kzsh4124/class-info-media-experiment-B/report/img/ver2_machine.jpg

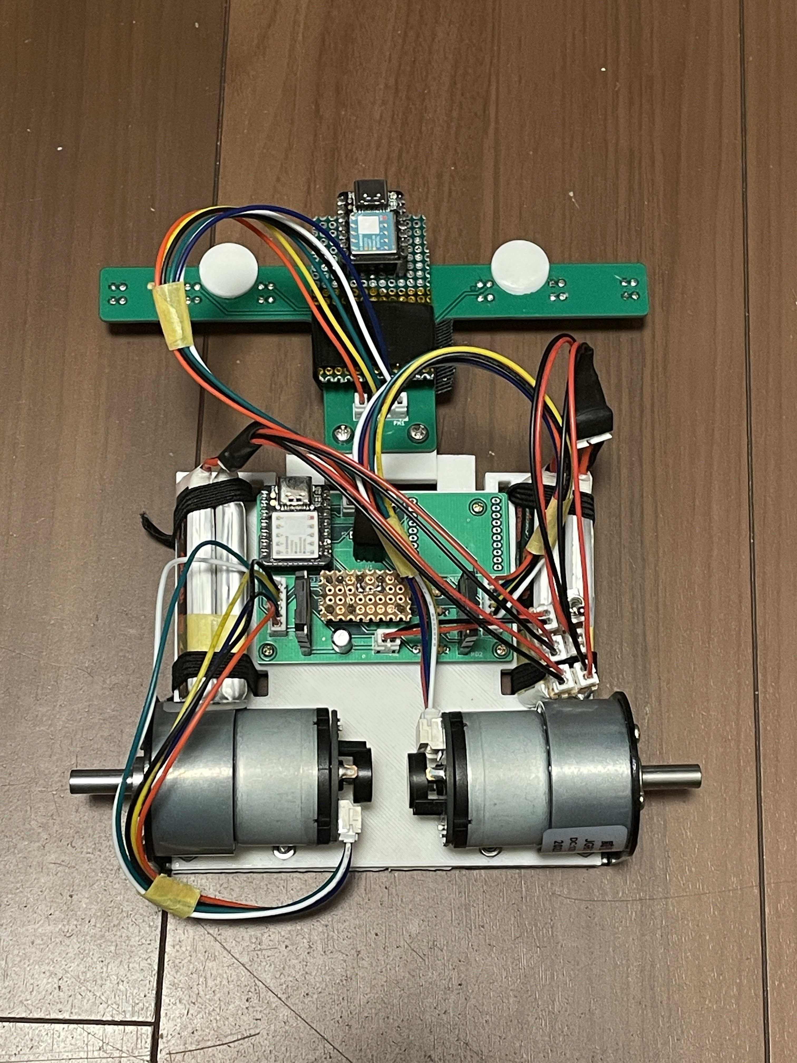
report/img/ver2_machine.jpg
