kzsh4124/class-info-media-experiment-B/report/img/ver1_machine.jpg

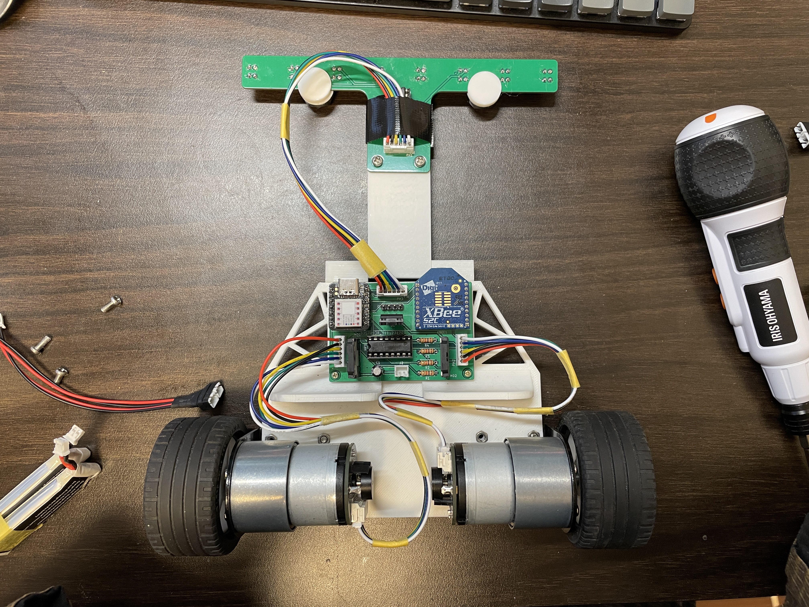
report/img/ver1_machine.jpg
