kzsh4124/class-info-media-experiment-B/report/main.pdf

# 情報メディア実験 B レポート ライントレーサロボットのフルスクラッチ実装

## Kazushi Nakamura

## 2024 年 2 月 7 日

目次

第 1 章 はじめに | 4
第 2 章 電気回路解析の基本 | 5
第 3 章 ハードウェア設計 | 19

1

第 4 章 ソフトウェア設計 | 21
第 5 章 評価 | 31
参考文献 | 32
付録 A 設計の変遷 | 33

2

付録 B インシデント、問題解決集 | 37

3

第 1 章

# はじめに

1.1 目的

本実験では、ライントレーサロボットの制作を通して、電気回路解析、制御工学に関する理論、および実際 のソフトウェア、ハードウェアへの応用を学ぶことを目的とする。ライントレーサロボットは、周囲と明るさ の異なるコース線（一般的には黒色または白色）を追従する非常に単純なロボットであり、最もシンプルな制 御方法とキットを用いればロボット製作が初めての小学生でも容易に制作が可能なレベルである。しかし、フ ルスクラッチで設計し、高速で追従させようとすると必要な知識は広範にわたり、難易度は高くなる。本レ ポートでは、ロボット製作の過程での学習成果、および、実際のロボットの設計、製作方法、評価についてま とめる。

## 1.2 本レポートの構成

2 章では、電気回路解析の基本についての学習成果として、直流回路および交流回路の解析手法、過渡現象、 よく用いられる素子系についてをまとめる。3 章は制御工学の基本についての学習成果をまとめる。2, 3 章の 内容は一般的なものであるから、読む時間がない場合は飛ばして次の 4 章から読むことを推奨する。4 章では、 実際に走行体に使用したハードウェア設計について部分に分割して示す。5 章では、ソフトウェア設計につい て、システム構成、制御手法および、部分ごとの実装について示す。これら設計に関する章ではこれから作ろ うとする人に向けた解説という体で記述している。6 章では、走行体の評価、振り返り、改善点、感想等につ いて示す。

4

第 2 章

# 電気回路解析の基本

2.1 概要

本章では電気回路解析の基本的な方法について学習したことを解説する。学習には教科書 [1] を使用した。 ロボットを作るときには、回路設計が必要不可欠である。正しい知識のもとに回路設計を行えば初歩的なミス による部品の破壊が減らせるほか、トラブルが発生したときの原因究明にも回路解析の知識が役に立つ。もち ろん、ここで扱うすべての知識が今回のロボット製作に直ちに役に立つ訳では無い。たとえば、電気回路解析 のメインテーマは直流回路ではなく交流回路であるが、今回のロボット製作で交流回路を利用している人はい ないだろう。しかし、直流回路であっても DC-DC コンバーダのように交流に似た理論で動く部品は存在する し、発振器を使用した回路も決して珍しくない。コンデンサはどうだろうか。直流回路にコンデンサは登場し ないが、実際に扱う回路は理想的ではないから過渡現象が存在することを忘れてはいけない。そして、電源基 板のような部分には過渡現象を抑えるためにコンデンサが使われているが、それを解析するためには交流回路 の知識があったほうが便利である。一通りの知識を抑えておくことで直接的には関係ないように思われる場面 で役に立つことは非常に多い。
本章では高校で学習するキルヒホッフの法則を紹介したあと、キルヒホッフの法則よりも楽に早く回路を解 析するための手法を紹介し、キルヒホッフの法則からの脱却を図るというコンセプトで電気回路解析の基礎を 解説する。

## 2.2 電気回路の導入

2.2.1 導入

それでは早速始めよう。まず、電気回路にはどのような構成要素があるだろうか。非常にシンプルである。 基本的には、電源、配線、抵抗という 3 つの要素しかないと考えて問題ない。これは直流回路に限らず、交流 回路の世界ではコンデンサ、インダクタといった素子が登場するものの、驚くことにこれらの素子は一定の手 続きを踏めば抵抗と同じように考えて解くことができるのである。*1 次に、電気回路が解けるとはどのような状態であるだろうか。多くの場合、既知の素子を接続した回路上で

*1 注意点としては、電気回路の世界ではほとんどの場合「線形の回路」のみを扱う。線形な回路は線形な素子から構成される。少し 難しく感じられるが、線形な素子であるかどうか大雑把に判定するな方法としてはオームの法則に従うかどうかを考えれば良い。 豆電球のような非オーム抵抗は線形な素子ではない。その他にも、半導体素子であるトランジスタやダイオードなども線形な素子 ではない。これらは電子回路の範囲で扱うものである。

5

任意の点の電流と、2 点間の電圧が求められている状態を指す。よって、我々は「電流」と「電圧」について 正しい理解をする必要がある。

## 2.2.2 電流と電圧

まずは電圧から考えよう。電磁気学を学んだ人に説明するなら、「単位電荷に換算した静電気力のポテン シャルエネルギーである電位の 2 点間の差」「電場を積分して求められる電位の 2 点間の差」などと言えば十 分であるが、実は、電磁気学を学んでいない人に電圧の概念を正しく理解してもらうのは意外と難しい。たと えば、中学理科を説明しているトライさんのサイト [2] では、「電圧のイメージは、流れる電子 1 粒のいきお いのこと」「電流 のイメージは、1 秒間に流れる電子の数のこと」とされている。この文章から電圧と電流の 違いがわかるだろうか？ 理解している人にとってはこの文章は大きく外してはいないことがわかる。しかし、 勢いが強いと言われれば、電子 (電荷) が高速で流れている状態をイメージしやすい。そして電荷のスピード というのはどちらかというと電圧ではなく電流の定義である。やはりよくわからなくなってしまった。 そこで、状況を説明するのに昔から用いられているのが水流のモデルである。これも正しく意味を吟味でき ていないと大きな誤解を招く諸刃の剣であるが、この考え方では次のように置き換えることができる*2。電源 ↔水を上に汲み上げるポンプ、配線↔水平な水路、抵抗↔水路中につけた水車、として閉じた水路を形成する。 このようにおけば、ポンプで水を持ち上げる高さ h に比例して単位時間あたりに水路中のある位置を通過する 水の量は増加する。もし、h = 0 であれば水が流れることはない。同じことが電気回路にも言える。電気回路 では、高さにあたるのが電圧、単位時間に水路の断面を通過した水の量が電流、となる。注意点としては、「高 さ」という量は常に 2 点間の差で決定されていて、1 点で絶対的に決定されるわけではないということである。 たとえばポンプで水を 5 m 汲み上げたとき、その基準となっているのは持ち上げる前の位置である。逆に、ポ ンプで水を汲み上げたあとの高さを基準の高さ 0 m とすれば、持ち上げる前の高さは-5 m である。おなじこ とが電圧にも言えて、電圧が 1.5 V の電池は負極を基準とすれば正極は 1.5 V であるが、正極を基準とすれ ば、負極は-1.5 V である*3。電圧と聞くと水圧のように 1 点で決まるものであると誤解しやすい。そういった 誤解をなくすために、電磁気学では電圧と同じ意味で「電位差」という言葉がよく使われることを覚えておく とよいだろう*4。
次に電流について考えよう。水流モデルを考えれば、水流は (水流) = (通過水量)/(経過時間) で表現でき る。同様に電流を表現すれば、

I(電流) = Q(電荷の通過量)/t(経過時間)

となる。これを拡張して微小時間でも同様の性質が成り立つと考えれば、

i(t) = dq(t)
dt
が成り立つ。

*2 水流モデルには圧力に基づくモデルと高さの差に基づくモデルの二種があり、あまり明確に区別されずに用いられてきたことが文 献 [3] で考察されている。
*3 回路図中では電圧の基準点は GND(グラウンド) と書かれることが多い。
*4 電位と電圧は似た使われ方をするので少々わかりにくいことがある。気持ち的には、明示的には書かれていないが、どこかに基準 があることを前提としてある 1 点の電気的な高さを述べたいときには電位と表し、2 点を明示してその電気的な高さの差について 述べているときには電圧と書く。

6

img/ohm.drawio.png

図 2.1

では抵抗はどのような装置であると考えられるか。抵抗はエネルギーを別の種類のエネルギーへと変換して 取り出す装置である。水車は水の位置エネルギーを主に運動エネルギーへと変換する。同様に、電気回路中の 抵抗は電気エネルギーを主に熱エネルギーへと変換する装置である。

### 2.2.3 オームの法則

図 2.1 ような単純な回路を考える。水流モデルと同様に、電気回路でも与えた電圧 E に比例して電流 I は 増加する。このとき、以下の式が成り立つ。

E = RI
この係数 R が抵抗である。同じ電圧ならば抵抗が大きいと電流は小さくなるため、抵抗は電流の流れにく さを表す。通常、R は時間によらず一定であるとみなして解析するが、実際の抵抗は温度変化による抵抗値の 変動があるので注意する必要がある。R が一定であるとみなせるとき電圧と電流は比例し、このような関係は 線形性とよばれる。電気回路の諸定理の中には線形性を満たすものにのみ適用できるものも多いから適用範囲 に注意しなければならない。
また、抵抗の逆数 G = 1/R を用いると、オームの法則は以下のように変形できる。

I = GE
この G をコンダクタンスとよび、電流の流れやすさを表す。

## 2.2.4 理想電源

理想電圧源
回路の状態によらず、常に負極と正極の間の電圧が一定であり、一切の内部抵抗がない電源装置を理想電圧 源と呼ぶ。
実際の電源装置は理想電源ではない。たとえば、生活の中で身近な直流電源装置として、電池があげられ る。電池は利用しているとだんだんと消耗し、両端の電圧が下がっていく。また、瞬間的に大きい電流が流れ たときに両端の電圧が下がることがあり、やはり一定とは見なせない。そして、電池は内部抵抗が存在するた め純粋に電源の機能だけとは見なせないのである。

7

img/real_battery.drawio.png

図 2.2 現実の電源の等価電圧源と等価電流源

理想電流源
回路の状態によらず、常に接続部分に一定の電流を流す電源装置を理想電流源と呼ぶ。 電圧と電流の因果律を考えれば、電圧があることが原因で電流が生じるから、電流源はより現実の電源装置 からは離れた概念である。しかし、後述するように電源の等価変換を考えることにより回路解析では有用な場 面がある。

現実の電源の等価電源
先に述べたように電池のような現実の電源は理想電源ではない。しかし、内部抵抗を考慮することで、より 現実に近い電源モデルを考えることができる。図 2.2 のように、電圧源の場合は理想電圧源 E と直列に抵抗 Rin を挿入し、電流源の場合は理想電流源 I と並列に抵抗 Rin を挿入することで、内部抵抗を考慮した電源 モデルとなる。
2.2.5 電力

電気が単位時間に行う仕事、すなわち、仕事率のことを電力とよぶ。ある抵抗 R で消費される電力 P は、 抵抗にかかる電圧 V と抵抗に流れる電流 I を用いて、以下のように表される。

P = V I = RI² = V

2
/R
電力の単位は W (ワット) であり、[W] = [J]/[s] である。

## 2.3 直流回路の解析

### 2.3.1 電圧上昇と電圧降下

オームの法則を用いることで、単純な回路については解析することができる。 ここで、回路解析のうえで重要な概念である「電圧上昇」と「電圧降下」の概念について説明する。図 2.3 のような回路を考える。ただし電圧の矢印は電位の低い方から高い方へ向けて書くことと約束する。この回路 において、1

0 を基準とした各端子の電位を考える。電流の向きに沿って考えると、まず、1

0 から 1 へ移動する
間の電源で E の電圧上昇があるから 1 の電位は E である。次に、1 から 2 に移動する過程では抵抗 R1 によ

8

img/ohm2.drawio.png

図 2.3

り、V1 = R1I の電圧降下がある。そして、2 から 1

0 に戻る過程で抵抗 R2 により、V2 = R2I の電圧降下があ る。これらから方程式を導くと、

E = V1 + V2
= R1I + R2I | (2.1)

となる。つまり、
(電圧上昇の和) = (電圧降下の和)

あるいは、
(電圧上昇の和) − (電圧降下の和) = 0

が成り立つ。
次に、同じ意味であるが他の見方を示そう。図 2.3 を見ると、電源電圧 E は電流の方向に沿って上昇してい る一方で、抵抗 R1, R2 にかかる電圧は電流と逆の向きに沿って上昇していることがわかる。このような状況 は、抵抗が「逆向きに接続された電源」のように振る舞っていると解釈することができる。この逆向きの電圧 を「逆起電力」と呼ぶことがある*5。これを式にすれば、
(電源による起電力の和) = (逆起電力の和)

となり、これは前に示した電圧上昇、電圧降下によるモデルと等価な式である。

### 2.3.2 キルヒホッフの法則

オームの法則により、ループが 1 つしかない回路については解くことができる。より一般的に、ループが複 数の回路でも適用できる法則がキルヒホッフの法則である。

キルヒホッフの電圧則 (KVL)
回路中にある閉ループをとる。どのような経路を通ってきてもループを 1 周して戻ってきたときの電位は最 初と同じである。

*5 抵抗による逆起電力という言葉は交流回路で登場するインダクタ（コイル）による逆起電力と本質的に別の仕組みであるため、混 同を防ぐため使わない方がよいという意見もある。回路方程式を立てるうえでは両者とも電流の逆向きに沿って正の起電力がある と見なせるので同じ手続きで問題ない。

9

つまり、より複雑な回路についても、任意にループを定めたとき、先に述べた式

(電圧上昇の和) − (電圧降下の和) = 0

が成り立つ。
一般にループ内に n 個の電圧上昇があって i 番目の電圧上昇が Ei と表され、m 個の電圧降下があって j 番 目の電圧降下が Vj と表されるとき、以下の式が成り立つ。
Xn

i=1

Ei −

Xm

j=1

Vj = 0

キルヒホッフの電流則 (KCL)
ある点で回路が分岐しているとき、その点に流入する電流の総和とその点から流出する電流の総和は等し い。つまり、分岐点に電荷が蓄積されることはない。
これを式に表そう。ある分岐点に n 個の分岐があり、i 番目の線に流れる電流を Ii とする。ただし、流入す る方向を電流の正方向とする。このとき、次の式が成り立つ。

Xn

i=1

Ii = 0

## 2.3.3 閉路解析法

キルヒホッフの法則を使えば理論的にはどのような回路を解くこともできる。しかし、どの部分の値 (電圧、 電流) を仮定して、どのような立式をすればうまく解けるのかということは述べられていない。ここでは、統 一的な手順で回路を解くことができる方法のひとつとして、閉路解析法を紹介する*6。この方法は KVL を用 いた方法であるから、電源がすべて電圧源である必要がある*7。
図 2.4 のような回路を考えよう。この回路で各点に流れる電流はどのように表されるだろうか。 この回路で、まず、2 つの閉路に流れる電流（閉路電流、またはループ電流とよぶ）を仮定し、その 2 つの 閉路に成り立つ方程式を導くと以下のようになる。
(
E − R1I1 − R2(I1 − I2) = 0 − R2(I2 − I1) − R3I2 = 0

これを解くことで、I1 =

R2 + R3
R1R2 + R2R3 + R3R1

E, I2 =

R2
R1R2 + R2R3 + R3R1

を得る。
一般的な回路において、仮定が必要な閉路電流の数 l はグラフ理論の結果を用いることでわかる。電気回路 を節と辺で構成されたグラフと同一視する*8と、l は節の数を n、辺の数を b とすれば、以下の式が成り立つ。

l = b − n + 1

*6 節点解析法という KCL をベースとした手法もあるが、閉路解析法の方がシンプルで使いやすいことが多い。本稿では節点解析法 は省略する。
*7 後に紹介する電源の等価変換を用いれば電流源があっても解くことができる。
*8 何を節と辺に取るかというのは色々なやり方があるようで、たとえば、素子を節に取るやり方や、配線の交わる点を節に取るやり 方がある。個人的には後者の方がわかりやすいと思う。配線の交わる点とはある点から 3 つ以上の分岐があるものを指しているが、 仮に 2 つしか分岐がない点 (つまり配線の交点ではない点) を節にとっても、その分辺の数も増えるため結果は変わらない。

10

img/loop.drawio.png

図 2.4

### 2.3.4 キルヒホッフの法則の問題点

キルヒホッフの法則は理論的には万能であり、十分な情報が与えられていればすべての回路を連立方程式に 帰着させて解くことができる。
しかし、手計算で回路を解く場合、計算ミスをしやすいうえ、最善手とはならず、もっと楽に解く方法があ る場合も多い。なぜなら、キルヒホッフの法則では一般的に、仮定したすべての未知数を求めるまで解が定ま らない。実際に回路を解きたいときは、ある部分のみを知りたい場合も多いから遠回りになってしまうので ある。
ここからは、様々な解析手法を学び、キルヒホッフの法則から卒業しよう。

## 2.3.5 分圧、分流

分圧
キルヒホッフの方法から直ちに求められる公式が分圧、分流の式である。いま、再び 2.5 に示す直列回路を 考えよう。この回路についてキルヒホッフの法則を用いて解析すれば、以下の式が成り立つことが直ちにわか る。これを用いれば単純な直列回路ではキルヒホッフの法則を用いる必要がなくなるので時間短縮に役立つ。

V1 =

R1
R1 + R2

E

V2 =

R2
R1 + R2

E

分流
次に、図 2.6 の並列回路を考えよう。この回路では E から全体に電流 I が流れていて、分岐点で R1 側に I1、R2 側に I2 が流れている。これらの電流の関係を考えると、以下の式が成り立つ。

I1 =

R2
R1 + R2

I

I2 =

R1
R1 + R2

I

11

img/ohm2.drawio.png

図 2.5

img/para.drawio.png

図 2.6

分圧の式と比べると、分子の抵抗が逆になっていることがわかる。これらの式は形が似ているので覚えにくい かもしれない。そういうときには片方の抵抗を 0 や ∞ であると考えてみると正しい式かどうか確認すること ができる。

## 2.3.6 合成抵抗

複数の抵抗が直列や並列に配置されており、個々の抵抗に流れる電流や電圧には興味がないが、全体で流れ ている電流を求めたいということがあるだろう。あるいは、分流を求めるために先に全体の電流を求めたいこ とがあるかもしれない。そういった際には、回路に接続された複数の抵抗をまとめて 1 つの合成抵抗とみなし て解析する必要がある。
直列回路から始めよう。図 2.5 の回路において、2 つの直列抵抗をまとめてひとつの合成抵抗 R とすると、 オームの法則より、
E = RI
また、式 (2.1) より、
E = (R1 + R2)I

12

これらの 2 式を比較すると、

R = R1 + R2
である。直列に接続された合成抵抗は単純に和を取れば良い。 次に、並列回路について考えよう。図 2.6 において、次の 3 式が成り立つ。

E = R1I1
E = R2I2
I = I1 + I2
これら 3 式から、I = ( 1
R1

+

1
R2

)E が導かれ、これを合成抵抗 R を用いたオームの法則と比較すると、

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
よって、

R =

R1R2
R1 + R2
が成り立つ。
ここで、並列回路の合成抵抗をコンダクタンス G=1/R を用いた式で表すと、以下のようになる。

G = G1 + G2
直列回路では抵抗を用いた式が簡単に表されるが、並列回路ではコンダクタンスを用いると簡単に計算できる 場合がある。

### 2.3.7 電源の等価変換

2.2.4 節で電源には 2 種類あることを説明した。これらは互いに相容れないものであるわけではなく、相互 に変換することができる。改めて電源の図 2.7 を示す。図の左の電圧源を右の電流源に変換するときには、以 下のようにおけば良い。

I =

E
R1
R2 = R1
逆に、電流源を電圧源の形に変換するときには以下のようにおけばよい。

E = IR2
R1 = R2
これらの証明は 2.3.9 節で紹介するテブナンの定理を用いると簡単に与えられる。 この変換規則を見たとき、実際の回路には複数の抵抗があるが、どこまでを内部抵抗として扱えば良いのか 疑問をもつ人がいるかもしれない。結論から言うとそれは自由であり、どこまでの抵抗を内部抵抗として扱っ ても問題ない。後に説明するが、この変換規則と合成抵抗の公式を繰り返し利用して回路を簡単な等価回路に 置き換えて解くことができる。

13 img/real_battery2.drawio.png

図 2.7 現実の電源の等価電圧源と等価電流源

### 2.3.8 重ね合わせの理

重ね合わせの理は、複数の電源が回路中に存在するとき、任意の地点の電流および、電圧はある 1 つの電源 のみ機能していて他の電源を ‘ゼロ’ にしたときの値をすべての電源について重ね合わせたものに等しい、とい う原理である。この原理は回路に線形性があるときのみ成り立つ。電源をゼロにするとは、電圧源の電圧を 0、 電流源のある枝の電流を 0 にするということである。つまり、図 2.8 のように、電圧源を短絡（ただの配線に 置き換える）、電流源を開放する（配線を切り離す）ということに相当する。

img/short_open.drawio.png

図 2.8 電圧源の短絡 (左) と電流源の開放 (右)

たとえば、2 つの電源として電圧源 E0 と電流源 I0 が存在する回路があり、ある点 P での電流 I が知りた いとしよう。まず、E0 の働きを知るために、E0 のみ機能をもたせた状態にし、I0 の両端を開放する。その状 態での P での電流を求めると I1 であった、とする。
次に I0 の働きを知るために、I0 のみ機能をもたせた状態にし、E0 の両端を短絡する。その状態での P で の電流を求めると I2 であった、とする。
これらの結果から、I = I0 + I1 が求められる。 電源が複数あったからといってキルヒホッフの法則が使えなくなるわけではない。重ね合わせの原理は、よ り複雑な回路を解析するときに有用である。

14

### 2.3.9 テブナンの定理

テブナンの定理は、複数の素子から構成された回路網から取り出した 2 つの端子間を図 2.9 のように非常に 単純な等価回路に置き換える定理である。この図における等価回路の電圧 E を（2 端子間を開放したときの電 圧であるから）開放電圧と呼ぶ。R0 は 2 つの端子から内部を見込んだ内部抵抗である。2 つの端子間に抵抗 R が接続されているとき、この抵抗を流れる電流 I は以下のように表される。

I =

1
R0 + R

E
この定理を実際に適用する回路において、考える端子間は必ずしも開放されている必要はない。定理を適用す るときのみ自分で開放して考えれば良い。内部抵抗を求めるときには、回路網側の電源について、電圧源は短 絡、電流源は開放して考える。

img/Thevenin.drawio.png

図 2.9 テブナンの定理

## 2.3.10 定理の利用例

定理を活用して、以前閉路解析法で解いた回路を改めて解いてみよう。
✓ | ✏ 問題

図 2.10 の回路において、I1 と I2 を求めよ。

img/loop_re.drawio.png

図 2.10
✒ | ✑

15

分流と合成抵抗による解法
並列の抵抗を//の記号で表すとする。全体の合成抵抗は R1 + R2//R3 = R1 +
R2R3
R2+R3

=

R1R2+R2R3+R3R1
R2+R3
であるから、オームの法則より

I1 =

R2 + R3
R1R2 + R2R3 + R3R1

E
次に、分流を用いれば、

I2 =

R2
R2 + R3

I1

=

R2
R1R2 + R2R3 + R3R1

E .

電源の等価変換による解法
I1 は工夫できないので省略する。
I2 を求めよう。図 2.11 のように、電源の変換と合成を繰り返し適用すれば、最終的にオームの法則が適用 できる形になり、

I2 =

1
R1//R2 + R3

R2
R1 + R2

E

よって、

I2 =

R2
R1R2 + R2R3 + R3R1

E .

img/loop_eqv.drawio.png

図 2.11 電源の等価変換と抵抗の合成を繰り返す過程

先にも述べたが、この方法は段階的にテブナンの定理を利用しているのと等価である。

16

### 2.3.11 テブナンの定理による解法

I1 については、R1 の両端を開放して開放電圧と内部抵抗を考えると先に示した分流と合成抵抗による解法 と全く同じ形になるため省略する。
I2 について、R3 の両端を開放して、開放電圧と内部抵抗を求めよう。開放電圧 V は、R2 の両端の電圧に 等しい。よって、分圧を用いて

V =

R2
R1 + R2

E
内部抵抗は、E を短絡して考えると、

R = R1//R2

=

R1R2
R1 + R2
よって、R3 に流れる電流は、

I =

1
R + R3

V

=

R2
R1R2 + R2R3 + R3R1

E .
このように種々の公式を利用することにより、キルヒホッフの法則よりも楽に答えを求めることができる。

## 2.4 正弦波交流回路の解析

## 2.4.1 正弦波交流

v(t) = Vm sin(ωt + θ)
の形で表された電圧 (または電流) を持つ回路を正弦波交流回路という。
ωを角周波数といい、周波数 f を用いて ω = 2πf と表される。Vm を振幅、θを位相といい、交流回路にお いては、振幅のほかに位相のズレまで考慮する必要が出てくる。θ = 0 のときに対し、θ = −
π

2 のときを位相
が π

2 遅れているなどと言い、逆に θ > 0 であれば位相が進んでいると言う。

### 2.4.2 交流回路上の素子

抵抗
交流回路上に抵抗がある場合について考察しよう。直流回路におけるオームの法則は R が不変ならば E = RI が成り立つことを約束するものであった。実はこの法則は、電圧や電流がが時間変化したとしても成 り立つとして拡張してよい。ゆえに、抵抗の両端に正弦波の電圧を印加すれば、

v(t) = Ri(t)
i(t) = Vm
R

sin(ωt + θ)

17

よって位相は同相であり、電圧の振幅 Vm、電流の振幅 Im に対し、

Vm = RIm
の関係がある。

コンデンサ
インダクタ
インダクタはコイルとも呼ばれる、鉄心、フェライトコアまたは空心にエナメル線等の導線を巻き付けた素 子である。電磁気学によれば、コイルに流れた電流が時間変化すると、自己誘導により逆起電力 v(t) が発生 し、以下のように表される。

v(t) = L

di
dt
この関係は以下の積分形式でも表される。

i(t) = 1
L

Z t

−∞

v(t)dt

これらの式において、L をインダクタンスと呼び、ヘンリー [H] の単位を用いる。

## 2.4.3 複素記号法

## 2.5 過渡現象 2.6 回路素子の性質

18

第 3 章

# ハードウェア設計

## 3.1 ハードウェア概観

本章ではハードウェア設計について説明する。

## 3.2 部品表

以下に部品表一覧を示す。

## 3.3 ベース

ベースは 3D プリンタを用いて造形されており、材質は PLA フィラメントである。部品としては本体、セ ンサ部連結パーツ、接地部、その他小部品に大別される。以下図を示す。

## 3.4 光センサ部

光センサ部は、プルアップ抵抗とフォトトランジスタによる光センサが 8 個付いており、これらの信号はセ ンサ用マイコンに送られて 1 つの信号に集約されたうえでメイン基板にアナログ値として送られる。回路図は 以下のようになっている。

## 3.5 光センサ拡張マイコン基板

本来は光センサ出力はマルチプレクサを経由してメイン基板ですべて処理される予定であったが、問題が発 生したため、マルチプレクサの部分からユニバーサル基板を生やし、その基板上に別のマイコンを載せて別処 理させることになった。前方にマイコン接続用の USB Type-C が飛び出しているため、正面衝突に弱く、拡 張マイコンごと外れることもあるため、取り扱いに注意しなければならなかった。

## 3.6 メイン基板

メイン基板は、光センサ、エンコーダなどすべてのセンサ値を集約し、モータを適切に制御する役割があ る。基板上の役割は電源回路と信号回路に大別される。

19

電源回路としては、公称値 3.8 V のバッテリを 4 セル直列接続した約 16 V の電源と、レギュレータによっ て 5 V に降圧された電源の 2 種類の電圧が運用されている。16 V 電源はモータを回すために使用し、5 V 電 源はマイコンやセンサを作動させるために使用されている。元電源側にコンデンサを並列に挿入してあるた め、瞬間的な電圧変動にもある程度の耐性をもつ。
信号回路は、センサ値の取得、マイコンによる制御、モータの PWM 制御等に使用されている。 回路図は以下のようになっている。

## 3.7 電源基板

バッテリセルを 4 つ直列接続するための PH ソケットが並んだユニバーサル基板。すべての電源はこの基板 から取られている。スイッチもこの基板に実装されている。

20

第 4 章

# ソフトウェア設計

## 4.1 ソフトウェア概観

## 4.1.1 全体構成

本章ではソフトウェアの構成に必要な理論について説明する。今回構成した走行体には、光センサとモータ のエンコーダという 2 つのセンサが搭載されていおり、それらの値をモータの制御に反映したフィードバック 制御アルゴリズムを構築する必要がある。そこで本機ではモータの回転速度を制御量、PWM 制御の入力量を 操作量とした PID 制御を用いることとした。ただし、一般的に PID 制御は 1 入力 1 出力の系であるから、光 センサとエンコーダという 2 つのセンサ値のある系ではそのまま適用することができず、少し工夫が必要とな る。ライントレーサの制御には例えば ET ロボコンについての記事 [4] が詳しい。これによれば、光センサの PID 制御値とエンコーダの PID 制御値をそれぞれ計算し、和を取ったものを直接操作量として PWM 制御に 入力すればよいとされている。この手法は両方の制御がダイレクトに操作量に反映されるのでよいパラメータ を設定できれば非常に応答性が高いプログラムになると思われる。しかし、6 つのパラメータを同時に調節す る必要があり、走行の様子からどのパラメータをどの程度調節すればよいのかを見極めるのは初学者には難 しい。そのため、今回はセンサ値の PID から各モータの目標速度を変更し、その速度に向かってモータ側の PID 制御を行うという 2 段の PID 制御を行う方式を最終的に採用した。この方式は、センサ値から直接操作 量を変更しないで間にモータ側の PID 制御を挟むため、必ずしも最適な速度制御とはならない可能性、およ びディレイがある可能性があることが欠点である。しかし、モータ側の PID パラメータの調整とセンサ側の 調整を切り離し、1 度に 3 つのパラメータのみ対象として調整することができることがメリットである。この 構成をブロック線図的に示すと、以下のようになる。
PID 制御器が 2 つ直列に接続されていること、および速度の PID 制御の前で 3 つの値の加減算が行われて いることが特徴的である。

## 4.2 光センサ値の検出

### 4.2.1 コース線の中心の推定

先に述べたように、本機は 8 つのセンサを積んでいるが、PID 制御に回すためには 1 つのスカラ値に変換す る必要がある。センサ値の統合には様々な方法があるが、線が機体の外側に行くほど絶対値の大きい値を返す ような単調な関数となっていることが望まれる。そこで、本機では 2 つのモータを結んだ線の中心から、コー

21

img/block_line.drawio.png

図 4.1 採用したシステムのブロック線図

ス線の中心と推定される位置の角度をセンサ値として利用する。ここで、コース線が左側にあるとき、負の値 を返し、右側にあるときに正の値を返すとする。位置関係を示すと、図 4.2 のようになる。 まず、コース線の中心位置を推定する方法を考えよう。図の左側のセンサから順に 0 番から 7 番であるとす る。車体の中心線 car_censor を基準として右側を正、左側を負とする座標系を考えると、各センサの位置は 0 番から順に-7, -5, -3, -1, 1, 3, 5, 7 [cm] にある。つまり、i 番目のセンサ位置 Pi は

Pi = −7 + 2i
である。次に、センサ i がコース線に乗っているか判定する関数を b[i] とすれば、

b[i] = (
1 (センサiがコース線上にある)
0 (センサiがコース線上にない)

b[i] はセンサの実測値に対してしきい値を付けることで容易に実装することができる。 よって、これらを足し合わせ、“コース線上に乗っている” センサ数 N で割り、平均を取ることでコース線 の推定位置 Pe は

Pe =

1
N

X

7

n=0

b[i]Pi

## 4.2.2 角度の推定

次に、車軸から見込んだ推定角度 θe を求めよう。本機において、車軸とセンサのある位置までの距離

dbase = 13[cm] である。また、tan θe =
Pe

dbase である。ゆえに、

θe = tan⁻¹ Pe

dbase
である。

22 img/sensor_theta.drawio.png

図 4.2 位置関係

三角関数は計算量が他の演算に対して大きいのでボトルネックとなることがある。その際には、tan⁻¹ をテ イラー展開して、適当な次数で切ることで冪関数として扱えば良い*1。今回の配置であれば、5 次近似程度あ れば十分な精度である。しかし、実際に実験した結果、今回は特にボトルネックにならなかったので、検討は したものの、特に必要はなかった。

### 4.2.3 読み込みのボトルネック

以上で 8 つのセンサを 1 つのスカラ値に変換することができた。この処理では 8 つのセンサを順次読みこ むことから、ボトルネックとなり得ることに注意する必要がある。実は当初設計では採用したマイコンではピ ンが不足していたのでマルチプレクサを順次切り替えて処理する形式を取っていた。しかし、実際に試したと ころ、回路設計の関係なのか、1 度切り替えてから電圧が安定するまで 110 µs 程度要することがわかった*2。 このディレイは毎回挟むと後述の速度検出のサンプリング周波数が不足するため解消する必要があった。その ため、本機ではマイコンを 2 台利用するように設計を変更し、光センサ値の検出に関係する部分をすべて移動

*1 arctan x のテイラー展開は 2 次近似まで x であるから、大きさの正規化さえ気をつければ Pe を直接角度の推定値として扱っても あまり問題はない。今回は精度を優先した。
*2 マルチプレクサ側の問題ではない。モーターのエンコーダも同様にマルチプレクサを使っていたが、3 µs 程度のディレイで問題な く動作した。

23

した。遅延への懸念から、光センサ用マイコンから本マイコンへの通信には通信プロトコルを使用せず、適切 なレンジにマッピングしたアナログ値 (電圧) を出力し、受け取り側で扱いやすい値に再マッピングすること で問題なく利用することができる。今回は受け取り側で [-10, 10] の範囲に再マッピングした。

## 4.3 速度の検出

## 4.3.1 エンコーダ

速度の検出にはモータに付いているエンコーダを活用する。エンコーダにはホールセンサが付いており、 車輪を回転させると、1 回転で決まった回数 P だけデジタルでパルスが送られる。本機においては P = 11 である。つまり、信号を f(t) とし、モータを定速で回転させたならば f(t) = 1 (HIGH) となる時間と、 f(t) = 0 (LOW) となる時間を周期的に繰り返す。通常モータは正転と逆転を判別するために位相の異なる ホールセンサが 2 つ搭載されている。しかし、今回はモータは逆転しないものとし、1 つのエンコーダにのみ 着目する。

### 4.3.2 センサ値のサンプリング

デジタル値が流れている生データから速さを取得するためには、信号の値の変化を捉えてその時間間隔を調 べればよい。1 つのエンコーダで捉えられる値の変化は HIGH to LOW または LOW to HIGH の 2 種類で ある。仮に両方の変化を捉えるとすれば、1 回転で 2P 回の変化を捉えることとなる。一般に、より多くの変 化を捉えるほうが精度のよい速さが求められるが、サンプリング周波数に注意する必要がある。プログラム中 で速度を毎ループ計算せずに非同期で処理する場合、1 ループにかかる時間の逆数がサンプリング周波数であ る。そして、1 ループで 1 回の変化が起こる状態 (毎回のループで HIGH -> LOW -> HIGH と変化している 状態) が取得しうる最高速度であり、それ以上の速度は測定できない。しかし、そもそもナイキスト定理を考 えれば、この状態はすでにエイリアシングが発生して精度が低下しているから元の信号の周波数は更に低くな ければいけない。さらに言えば、ナイキスト定理では 2 倍のサンプリング周波数があれば良いことになってい るが、波形を復元する特別な工夫がないなら 10 倍以上の周波数を使うべきである。フーリエ変換を考えて厳 密に言えば、デジタル信号は矩形波であるから、無限大の周波数がなければ修復できない。そのため、どのよ うなサンプリング周波数で計測しても、たまに飛び値が出る。しかし、モータは瞬間的に追従することはでき ないうえ、次の瞬間には正しい値に戻っていることを考えれば飛び値が出ることは問題にならない。そして、 LOW->HIGH->LOW をあたかも 1 つの波であるかのように捉えてその周波数を考えてみればこの計測法で も比較的正しい速度が計算できることがわかる。こちらで考えても周波数が高すぎるときは、変化の読み落と しが発生しているので全く信用にならない。本機では LOW to HIGH のみを捉えることとする。 ここまでは、非同期で処理する場合を考えた。では同期処理ではどのような問題があるだろうか。まず、同 期処理では毎回の処理でそのときの速度を定める。つまり、毎回速度が確定するまでこの処理のみを実行する ので、読み落としは発生せず、エイリアシングの問題等は一切考える必要がない。ここだけ聞くと、同期処理 のほうがよく聞こえるかもしれないが、問題はこの処理が終わる (= エンコーダの変化を 2 点で捉える) まで 次の処理に進めないことである。高速走行時には短い時間で変化を捉えられるので大きな問題にはならないか もしれないが、低速時には待ち時間が増えるし、停止時には停止しているかどうかを明確に判別できるだけの 最大待ち時間待たなければならなくなる。その時間はモータに依存するが本機においては最低でも 20ms で あった。つまり、1 ループに最大 20ms、高速走行時でも非同期処理よりは当然遅く、数 ms の待ち時間が発生

24

する。待ち時間とはつまり制御が入らずに空走する時間である。例えば、50cm/s で走行中に 5ms の待ち時間 があったとすると、空走距離は 50cm/s ×5ms = 0.25cm である。僅かな量に感じるかもしれないが、これだ けの空走距離があると急なカーブ等には対応することが困難である。つまり、同期処理で速度を取得すると非 常に大きなボトルネックになるので、速度の計算は非同期処理にする必要がある。

### 4.3.3 生データから速さへの変換

前節でモータ 1 回転に捉える変化数を決めた。改めて P とおく。つまり、本機においては P = 11 である。 次に、値の変化にかかった時間を ∆t [µs] とする。モータのギア比 (減速比) を R とする。タイヤの直径を D [cm] とすれば、タイヤ外周部の速度 v [cm/s] は次のように表される。

v =

πD × 10⁶
RP ∆t
これは実質的に時間の 1 変数関数であり、残りは機体に固有の定数であるから、切り分けて前処理に回すこ とで処理を高速化できることに留意したい。また、車体が停止しているとき、∆t は永遠に求まらないため、同 期処理と同様に一定時間経過したら速度を 0 と判定するしきい値時間を用意する必要があることに注意する。

### 4.3.4 非同期処理の実装

本機は Arduino 互換ボードを使用しており、ソフトウェアの実装言語は Arduino 言語である。そのため、 Python 等高機能言語に実装されている async/await 等の高級な非同期処理インターフェースはない。そのよ うな状況でシンプルに非同期処理を実装するためには、時間を確認することが有効である。Aruduino 言語に は、経過ミリ秒を表示する millis() やマイクロ秒を表示する micros() が存在するため、それを用いることで 素朴な非同期処理を実装することができる。
その他の選択肢としては、今回は採用していないが割り込み処理にする方法が考えられる。ボード依存であ るが、Arduino は割り込み処理をサポートしている。ホールセンサの信号の変化をトリガとした割り込み処理 をすればより無駄のない速度計測ができる可能性がある。

## 4.3.5 ノイズ対策

エンコーダでは、ホールセンサの信号を HIGH と LOW で送信する。回転の途中で値の境界付近の状況に あるとき、短い周期で信号が震えることがある。これはスイッチにおけるチャタリングに近い現象であり、同 様に対策が必要となる。本機では、信号値を取得する際に毎ループで続けて 3 回取得し、すべての信号値が揃 わなければ信用できないとして信号を取得し直す、というロジックによりこの問題へ対処した。

## 4.4 モータ制御

## 4.4.1 センサの PID 制御

これまででそれぞれのセンサ値を取ることができた。次にこれをモータの動作に落とし込む必要がある。用 いる PID 制御を時間の式で示せば、

y = Kpe + Ki

Z
e dt + Kd

de
dt
25

ただし e は目標値から現在値を引いた偏差である。これはアナログ値であるから、デジタル値による記法に変 換する必要がある。これにはいくつかの流儀があるが、今回は最も基本的な方式として、微小時間は無視する、 積分要素は面積を取らずに現在差分を単純に足す、微分要素は差分要素に置き換えるという方法を取った。 今一度 PID 制御器の結果がどのように使われるか確認すると、光センサについての PID の結果は曲がる方 向に応じてモータの目標速度を変化させる役目をもつ。モータについての PID の結果はもちろん所望の目標 速度に近づくようにモータへ送る操作量を調整する。図 4.1 にブロック線図を示してあるから、あと必要なこ とはそのまま実装して、パラメータの調節を行うことのみ (これが一番大変かもしれない！) である。

### 4.4.2 光センサにおける PID 調整前のパラメータ推定

PID 制御のパラメータ調節は地道な作業であるが、論理的に考えられる部分については、ある程度あたりを つけてから始めると楽である。特に、PID 制御の調節は P 制御から始め、Kp の大きさによって他の値のレン ジの決定されるので、Kp の正当性が最も重要である。ここでは、光センサの P 制御値について考察を行うこ とでパラメータにあたりをつけてみよう。
ライントレースを行ううえで一番走行が難しいのは急カーブである。逆にいえば、急カーブを走行しても コースアウトせずに即座に車体の安定を取り戻せる状態なら他の場所は問題にならない。では Kp をいったい どのくらいの大きさにすれば最も急なカーブを曲がり切れるだろうか？
最も急なカーブの曲率半径を r[cm] とする。車体の中心線からタイヤの中心までの距離を d[cm] とする。与 えた走行速度目標を vt[cm/s] とする。ここで、走行速度目標とはカーブに差し掛かって光センサ値による補 正がかかった値ではなく、光センサ値によらない (つまり、直進中の値とも言える) である。ある瞬間、走行 体は角速度 ˙θ[rad/s] で円運動をしているとしよう。このとき、機体の制御により、外側の車輪の目標速度は vt + ∆v、内側の車輪の速度は vt − ∆v に変更される。ただし、∆v は Kp に依存する値である。このとき、速 度に関する次の 2 つの式が成り立つ。

vt + ∆v = (r + d)

˙θ

vt − ∆v = (r − d)

˙θ

ここから ˙θ を削除することにより、

vt + ∆v
vt − ∆v

=

r + d
r − d
= k
とおくと、k は r と d によって決まるからコースと車体のプラットフォームが変わらない限り定数である。こ の k を用いると、

∆v =

k − 1
k + 1

vt
と表される。つまり、光センサの PID 制御全体で ∆v より大きい速度の変化分を出せないと曲がりきれない ことが実験しなくてもわかる。
本機体について考えてみよう。本機体において、d = 7.5[cm] 速度 vt = 100[cm/s] で、曲率半径 r = 10[cm] の円を曲がるとする。このとき、k = 7 であるから、∆v =
6/8 vt =

3

4 × 100 = 75 である。いま、光センサ値
が [-10, 10] の範囲でマッピングされている。現在の光センサの値を l とする。光センサの目標値は中心である

26

0 とすれば e = l。ここでの偏差は定義とは反対であるが、その後のデータの与え方を反転させれば問題ない。 絶対値で扱っていると考えても良い。P 制御しか行わない状態を仮定すると、∆v = Kp|l| > 75 となる。光セ ンサが最大値のときにぎりぎり曲がりきれると仮定すると、l = ±10 で、Kp > 7.5 となる。実際にはもっと余 裕を持ちたいのでより大きな値となると推定される。たとえば、l = 8 で曲がりきりたいとすると、Kp > 9.38 程度となる。これと D 制御を組み合わせることで、急なカーブでもより安定して走行することができる。 実際に採用した値が Kp = 10.0, Kd = 12.5, Ki = 0.0002 であることを考えるとこの考察は非常に有益であ ることがわかる。

### 4.4.3 アドホックな調整

ここまでで、カーブを含めたほとんどの場合において安定した走行をするための議論は完了した。しかし、 まだ特殊な場合で安定しない可能性が残されている。本節ではそのような特定の状況に対応するアドホックな 処理について議論する。
安定しない可能性があるのは速度 0 からの立ち上がりの状況である。理由は 2 つある。
1 つ目は、目標速度を大きくすればするほど、初めの P 制御が強く効くからである。理想的状況であれば、 速やかに目標速度に到達するため問題ない。しかし、左右のモータの回りやすさに差がある場合、初めの制御 量が大きく入ると左右差が大きく出やすく、場合によっては修正する間もなくコースアウトしてしまう。 これに対応するためには立ち上がりの偏差に制限をかければよい。つまり、両輪が低速時に限り、現在速度 から逆算したターゲット速度を与えることで実現される。これは、数式モデルとしては異なるが、一次遅れ要 素に似た性質をもつ。つまり、以下のようにすればよい。

DelayAccelerationSpeed(targetSpeed, maxError, leftCurrentSpeed, RightCurrentSpeed) if leftCurrentSpeed < threshold and rightCurrentSpeed < threshold
newTargetL = min(leftCurrentSpeed + maxError, targetSpeed)
newTargetR = min(RightCurrentSpeed + maxError, targetSpeed)
return newTargetL, newTargetR
else
return TargetSpeed, TargetSpeed

副次的効果として、偏差の最大値が部分的ではあるが制限されることになるため、モータ側の PID 制御の Kp をより大きくしても問題が起こりにくくなる。すべての場合で偏差の最大値を制限すれば偏差が maxError 以 下であることが保証されるのでそれを念頭に置いた設計ができるが、急カーブを曲がりにくくなるという難点 があるため推奨しない。
安定しないもう 1 つの理由は、センサの PID 制御値の速度依存性である。4.4.2 節で速度に応じて与えるべ きセンサの Kp が変化することを述べた。もちろん Kp は目標速度に合わせて作られているから、立ち上がり の速度ではいささか強く効きすぎる。そして、先に述べたように、モータには個体差があるから同じように操 作量を与えてもまっすぐに進み出すわけではない。その結果、低速でラインを跨ごうとし、一方の車輪が完全 に止まろうとする、逆向きに曲がろうとしてもう一方の車輪が完全に止まろうとする、という動作を繰り返し て、振動的な挙動をしながら加速する。このような挙動ではスムーズな立ち上がりとは言えないから、対処し たほうがよい。
これに対応する解決策も単純であり、両輪が低速であるときにはセンサの PID の係数を書き換えれば良い。

27

もちろんなめらかに変化させることもできるが、低速用の係数を用意して、書き換えるか、書き換えないかと いう 2 段階があれば十分であると思われる。本機の場合は、50cm/s にチューニングした PID 値を用意して二 段階にしておけば十分安定した走り出しとなった。

## 4.4.4 Xbee との通信

低速で走行実験を行う場合、万が一コースアウトしても手で止めに行けば問題にならない。しかし、100cm/s といった高速で走行する場合、手で止めると機体にダメージが入ったり、手で止める前に壁に衝突する危険性 がある。走行会の前に事故によって機体が破損するといった事態は絶対に避けなければならない。これを避け るため、遠隔で発進と緊急停止を行うことができる機能があるとよい。やり方は様々あると考えられるが、本 機では Xbee を搭載して遠隔シリアル通信による発進と停止の機能を実装した。

## 4.5 ソースコード

長くなるので、GitHub のリポジトリに上げてある。
リンクは https://github.com/RiceCake1/LineFollow/tree/main. この節では、実装を関数別に簡単に解説する。なお、Arduino ではデフォルトで setup 関数と loop 関数が 必要である。setup 関数は起動時に 1 度だけ呼ばれる関数であり、ピンの設定や、初期化等を書く場所である。 loop 関数は setup 関数のあとに常に呼ばれる関数であり、メインループとなっている。

### 4.5.1 光センサ関係 (光センサ用ボード側)

float ReadSensorBinary(int sensorNum)
センサがコース線に乗っているか判定する関数。

float ReadSensor(int sensorNum)
アナログ値を読み [0,1] にマップして返す関数。デバッグ用。

int getLinePos()
以前使われていた、センサ値の統合アルゴリズム v1。

float getLinePosThetaWeighted()
以前使われていた、センサ値の統合アルゴリズム v2。角度を考慮し始めた。試行錯誤の痕跡。

float getThetaWithArctan()
最終的に採用された、センサ値の統合アルゴリズム v3。解説した通り単調な関数となっていて、非常に安 定性が高い。これに変更してからカーブ後の振動の収束が有意に早くなった。

28

### 4.5.2 光センサ関係 (メインボード側)

float getLinePos()
メインボード側で光センサ処理用マイコンから送られてきた値を読み、[-10.0, 10.0] の範囲に再マップする 関数。

float getPIDsensorValue(int linePos)
光センサの PID 制御値を計算し、返す関数。低速時に係数を変更するアドホック処理も含まれている。

### 4.5.3 エンコーダ関係

int _smoothEncoderSignal(int encoderNum)
ノイズ対策として 3 回エンコーダの信号を読み、すべて一致するまで繰り返す内部関数。

bool _isChanged(int encoderNum)
信号が変化したかを判定する内部関数。

float _getSpeedWithTime(int motorNum)
1 つのモータについて非同期処理で速度を取得する内部関数。

void getSpeedWithTime(float *spd)
上の関数を用いて両輪の処理をまとめた関数。

### 4.5.4 モータの制御関係

void controlMotor(float Rspeed, float Lspeed)
[-1,1] の値の 2 引数を取り、両輪の PWM 制御を簡単に行う関数。負の値ならば後退、正の値ならば前進。 本番環境では内部関数だが、デバッグ用途ではそのまま使える。

void delayAccelerationSpeed(float targetSpeed, float *newTargetSpeed, float maxError = 10) アドホック処理のための関数。立ち上がりの速度偏差に制限をかける。

void controlEachMotorWithPID(float rightTargetSpeed, float leftTargetSpeed)
左右モータの目標速度をそれぞれ引数に取り、PID 制御値を計算して、controlMotor でモータを制御する。

float limitSpeedOnCorner(float targetSpeed, float deacceleratedSpeed, int linePositon) 終盤に作られた失敗作。コーナーでは両輪とも減速すれば平常時の目標速度が速くても曲がり切れるのでは ないだろうか、という仮説に基づいて作られたアドホック制御関数。実際には、この関数が働き始めるときに はすでにブレーキには遅すぎる地点であることがわかった。消されたものも多いが、このプロジェクトにはこ のような不採用になった関数が山程存在し、その数だけ試行錯誤があった。参考までに、最終形である現在で

29

はメインボードのコードは 280 行程度であるが、一時期は 500 行以上あった (1 月 20 日のコミット)。

void controlMotorFromSensors(float targetSpeed, float deacceleratedSpeed=10) 最終的に採用されたすべてが集約された関数。センサ値の取得、光センサの PID 制御値の計算、モータの PID 値の計算、モータへの操作量の入力までがすべてこの関数で繋がった。

## 4.5.5 その他

float mapFloat(float InputValue, float InputLower, float InputUpper, float OutputLower, float OutputUpper) ある範囲内の実数を別の範囲にマッピングするための関数。

show...()
show 関数系は名前が示すものをシリアルで表示するデバッグ用関数。

initAll()
名前の通り、変数の初期化等をまとめている関数。setup で実行するほか、Xbee で停止させていた走行体 を再び走行させるときに実行される。

Xbee()
無線通信を行い、ソフトウェア的に停止、発進を行うための関数。高速でのデバッグでは壁に衝突するなど 事故が乱発していたため、必ず機体を緊急停止できる人員を配置し、その人の許可*3なく発進させてはいけな いという管制塔システムを導入した。その結果安全性が向上し、機体を破壊することなく無事本番を迎えら れた。

*3 電源を入れると発進する状態のときに “Cleared for run” の合図。後に電源を入れても自動で発進せず、管制管が発進信号を送る ように変更された。

30

第 5 章
評価

## 5.1 ループ速度 5.2 実測記録

5.3 感想

31

# 参考文献

[1] 友男鎌倉. 電気回路 (電子工学初歩シリーズ 3・4). 培風館, 単行本, 9 1998.
[2] トライイット. 電流・電圧とは　～電流・電圧のちがい、a(アンペア) と v(ボルト)～. https://www.try-it.jp/keyword_articles/52/.
[3] 亀山寛. 電気回路と水流モデルとの類推に関する考察（1）. https://shizuoka.repo.nii.ac.jp/record/2336/files/090305003.pdf. (https://shizuoka.repo.nii.ac.jp/record/2336/files/090305003.pdf)
[4] いもあらい。Et ロボコンの要素技術。, 2011. http://imoarai.cocolog-nifty.com/blog/2011/11/et-49b4.html. (http://imoarai.cocolog-nifty.com/blog/2011/11/et-49b4.html)

32

# 付録 A

# 設計の変遷

本付録では、最終成果物に至るまでの設計の変遷を示す。

## A.1 零号機

すべて ev3 を用いて授業初日に作り上げた機体。ev3 の性能評価のために使われた。この機体の評価によ り、初日にして ev3 を一切使わない設計に移行することを決定した*1。

## A.2 初号機

10 月中に作り上げた実験機。図 A.1 のように、配線はブレッドボードとジャンパ線、固定はマスキングテー プ、土台にいくつかのレゴパーツ、センサは本番機同様のもの、モータはエンコーダなしギアなしの DC モー タを直接搭載したプロトタイプである。加速力は非常に低いが、フィードバック制御がないため直線で際限な く速度が上がって次のカーブを曲がりきれずコースアウトする。一方でカーブが連続する地形では普通に走る ことができた。回路設計はこの機体のときにほぼ確定した。問題点を洗い出し、設計の原型を形作ったという 点で非常に重要な役割を果たしたプロトタイプである。これ以降は徐々に本番機に近づいていくが、変化が追 いやすい部分ごと紹介する。

## A.3 ベースの設計

## A.3.1 Version 1

初期には本年のコースはなかったので、昨年のコースに合わせた設計 (図 A.2)。結論から言うと、今年の コースは遥かに去年のものより難しく、物理的に曲がり切ることができない設計であったためボツになった。 この設計は高速走行を目指してホイールベースが大きめ*2に作られていたほか、横幅もゆとりがあった。高速 で走る走行体はセンサが車輪から遠いほど必要な回転量が減るので有利であることでこのような設計となって いたが、今年のコースの急なカーブに対応できず、改善が求められた。

*1 もちろん、そのほうが勉強になるという事実が後押しした。
*2 前輪がないのでこの用法は厳密には誤りなのかもしれないが、ここではセンサ下の接地部分と後輪間の距離をホイールベースと書 いている。

33

img/beginning_machine.jpg

図 A.1 初号機

## A.3.2 Version 2

最終的に採用された設計。本編で解説した通りのものである。ホイールベース、横幅ともに限界まで縮め、 旋回性能を上げた。

## A.4 メイン基板

## A.4.1 Version 1

最初に発注した基板。ピンアサインに問題があったので作り直しになった。

## A.4.2 Version 2

問題を修正し、ついでにパーツの配置を変えることで小型化した。

34

img/ver1_machine.jpg

図 A.2 ベース Version 1 を採用した機体

## A.4.3 Version 3

プリント基板自体が変更されたわけではないが、マルチプレクサを使わない設計に変更する必要が出てきた ためユニバーサル基板で設計を少し拡張した。

## A.5 センサ値の統合

## A.5.1 Version 1

各センサ i に単純な重み w(i) = −4 + i(0 ≤ i ≤ 3), −3 + i(4 ≤ i ≤ 7) を乗算し、単純に総和をとることで 統合した。原因はこの時点でははっきりしていなかったが、コースアウトすることが多かったため、改善に乗 り出した。

35

img/ver1_machine.jpg

図 A.3 ベース Version 2 を採用した機体

## A.5.2 Version 2

各センサの重みを車軸から見込んだ角度に変更した。センサ中心からの距離と arcsin を用いた実装であっ た。多少改善が見られたが、振動が収まらなかった。

## A.5.3 Version 3

最終的に採用されたシステム。重み付けして総和を出すのではなく、コース線の中心を推定することで単調 性を確保し、安定したターンを実現した。角度を求める関数も三平方の定理が必要ない arctan に変更され、 計算量が減少した。

36

# 付録 B

# インシデント、問題解決集

## B.1 概要

ロボット製作をしていると、原因不明の問題が次々と発生し、時間がどんどん吸い取られていくことがよく ある。本章では、開発中に実際にあったハマりどころを列挙し、原因を述べる。

## B.2 レギュレータの周波数特性

当初使用していた DC-DC レギュレータは高級な作りになっていて、レギュレータという名前にもかかわら ず、コンバーダのような仕組みだった。その結果、モーターが回転し始めた瞬間の過渡現象的な電源の電圧降 下を拾ってしまい、5V 出力のレギュレータが瞬間的に 2V 程度になりマイコンが落ちてしまうという問題が 発生した。電源側は 12V 程度供給していて、電圧降下したときも 9V 程度を維持していたからレギュレータ 側に問題があると気づくのに遅れた。コンデンサで安定化させ、レギュレータをシンプルな 3 端子レギュレー タに変更することで解決した。

## B.3 PH コネクタ接触不良

よくある話から。本機では、PH コネクタを用いていくつかの配線を束ねていたが、1 本だけ接触が悪いと いう状況は案外気づきにくく、「力を加えると精度が向上する」などと呼ばれていた。

## B.4 回路設計のミス

発注した基板の設計ミス。本来電源が供給されるべきところであるのに、浮島となっていて 0V となってい るところがいくつかあった。基板表面を削って適当に電源が供給されているところとはんだ付けすることで解 決した。
また、センサの基板で表裏を間違えていて、フォトセンサの素子の向きを全部直さないといけなくなった。

## B.5 マイコンのバグ

マイコンにプログラム書き込んで、そのまま使用すると 8 番ピンの出力電圧が不安定になるというバグ。書 込み後、一度電源と切り離し、再度電源と接続すると問題なく動作するため再現が難しく、ことあるごとに悩

37

まされた。個体差なのか仕様なのかは定かでない。

## B.6 温度特性

教室では良好に動いていたのに、家に持ち帰り確認すると全く違う値が出る。いったい何が違うのだろう？ その答えは素子の温度特性。寒い外気にさらされて持ち帰ってきた機体は、抵抗器も半導体素子も別の特性を 示すのである。現実の素子がいかに理想的でないか思い知らされる出来事である。

## B.7 何もしてないのに壊れた

一度も使用していなかったマルチプレクサが、正しく動作していなかった。初期不良か、静電気か。

## B.8 テスタの個体差

大きなプルアップ抵抗を使用していると、電圧を測ったとき、テスタ側の内部抵抗によって分圧され、思っ たのと違う値になる。普通の回路では気にならないが、1 MΩ の抵抗を使用していたため、テスタの内部抵抗 と同じくらいのオーダになっていたようだ。安物のテスタでは 2.1 V を示し、もっと良いテスタでは 3.5 V と いうことが起こり、再現性の無さに苦労した。

## B.9 これらの組み合わせ

これらの問題が独立に発生しているなら、まだ苦労しなかっただろう。しかし、2 つまとめて起こる、とい うことが頻発したため非常に苦労した。

38
