kzsh4124/class-info-media-experiment-B/report/img/beginning_machine.jpg

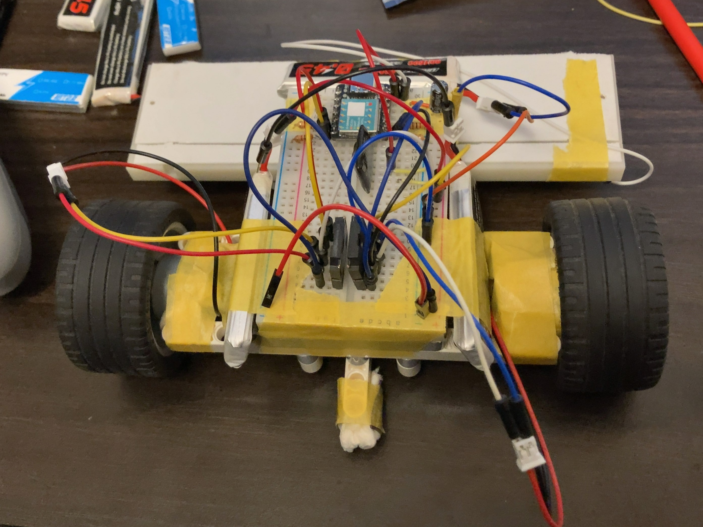
report/img/beginning_machine.jpg
