kzsh4124/class-info-media-experiment-B/report/img/block_line.drawio.png

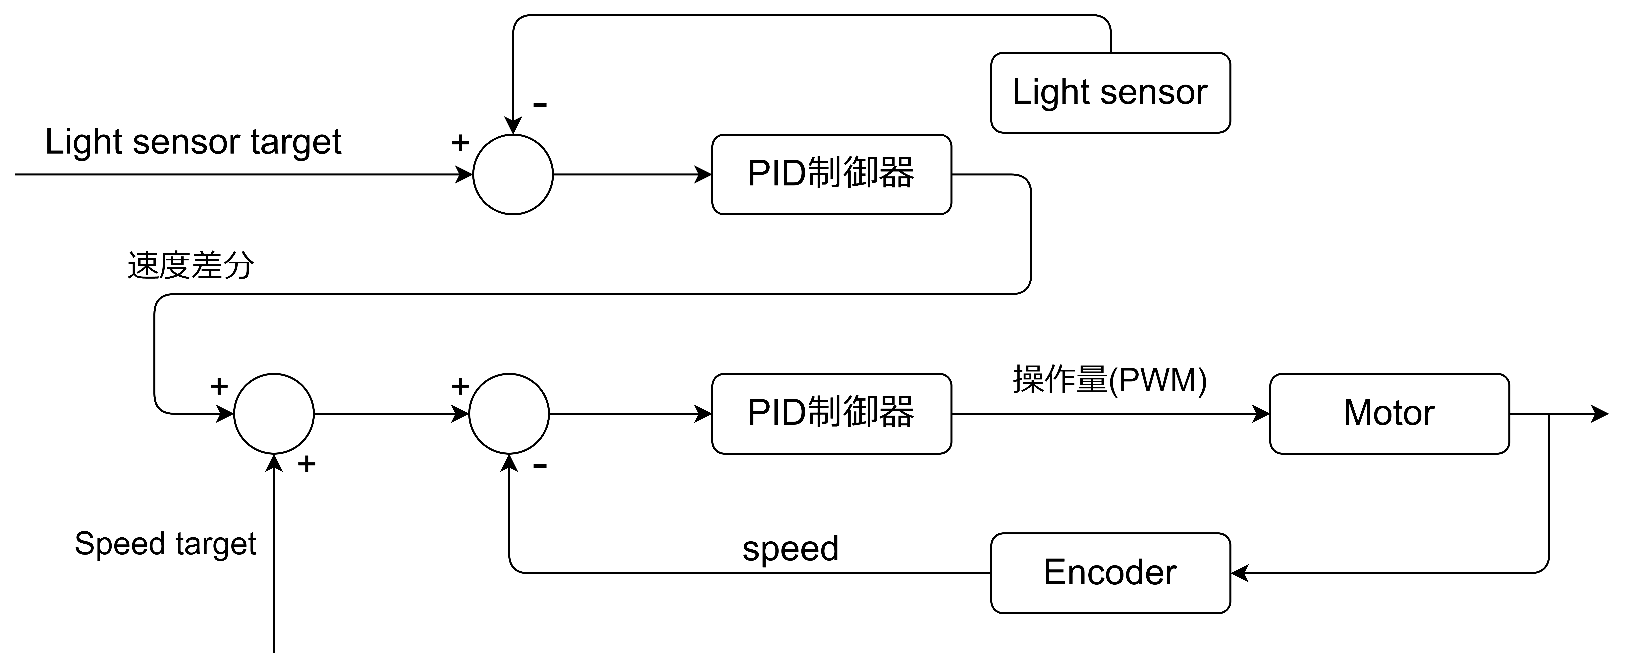
report/img/block_line.drawio.png
