kzsh4124/class-info-media-experiment-B/report/img/figure_all_circuit.png

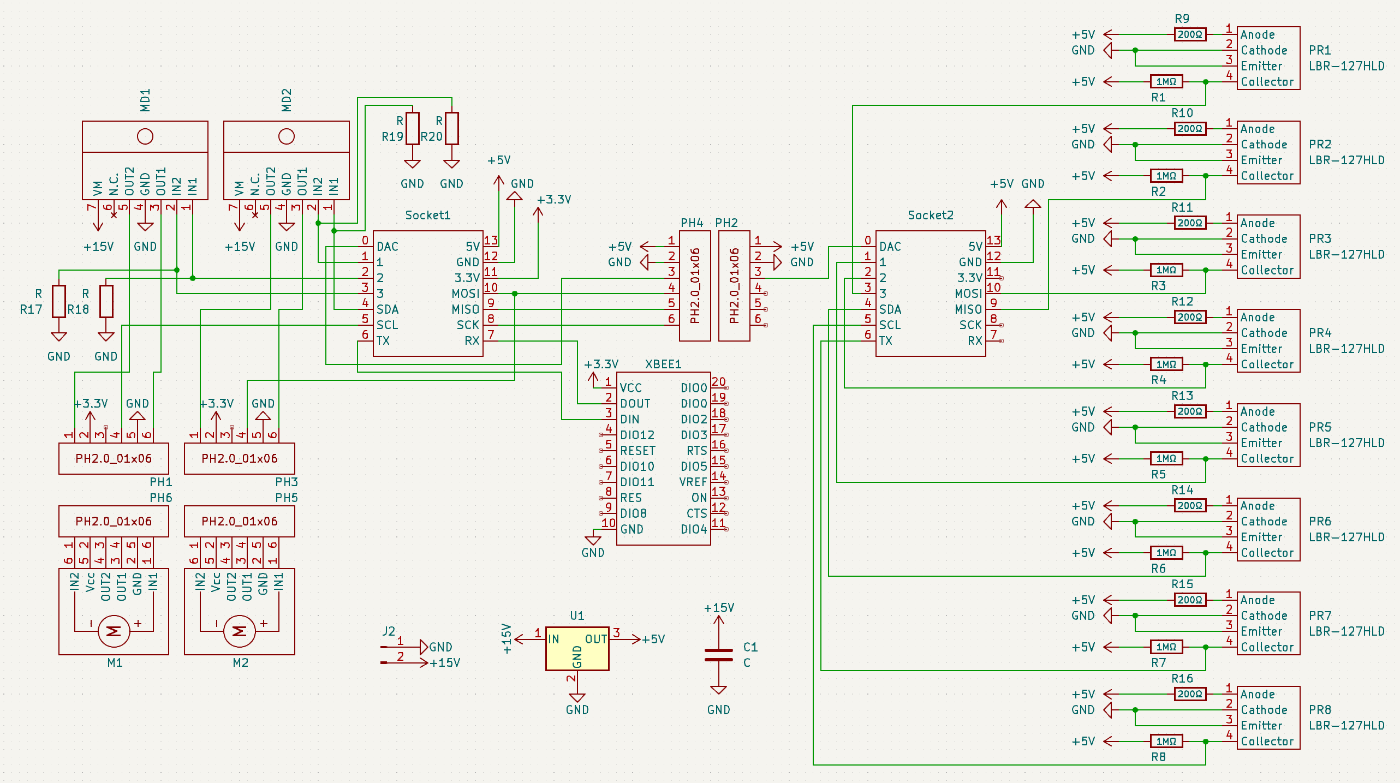
report/img/figure_all_circuit.png
