kzsh4124/class-info-media-experiment-B/report/img/figure_carFramev3_angle.png

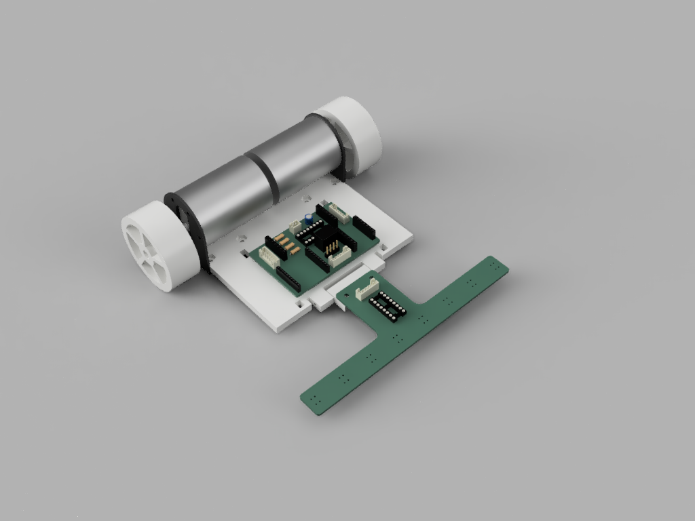
report/img/figure_carFramev3_angle.png
