kzsh4124/class-info-media-experiment-B/report/img/ks_estimate.drawio.png

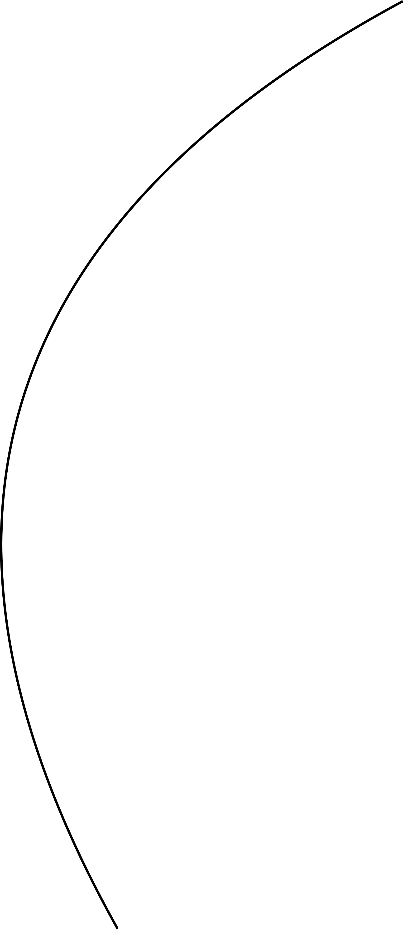
report/img/ks_estimate.drawio.png
