kzsh4124/class-info-media-experiment-B/report/img/loop.drawio.png

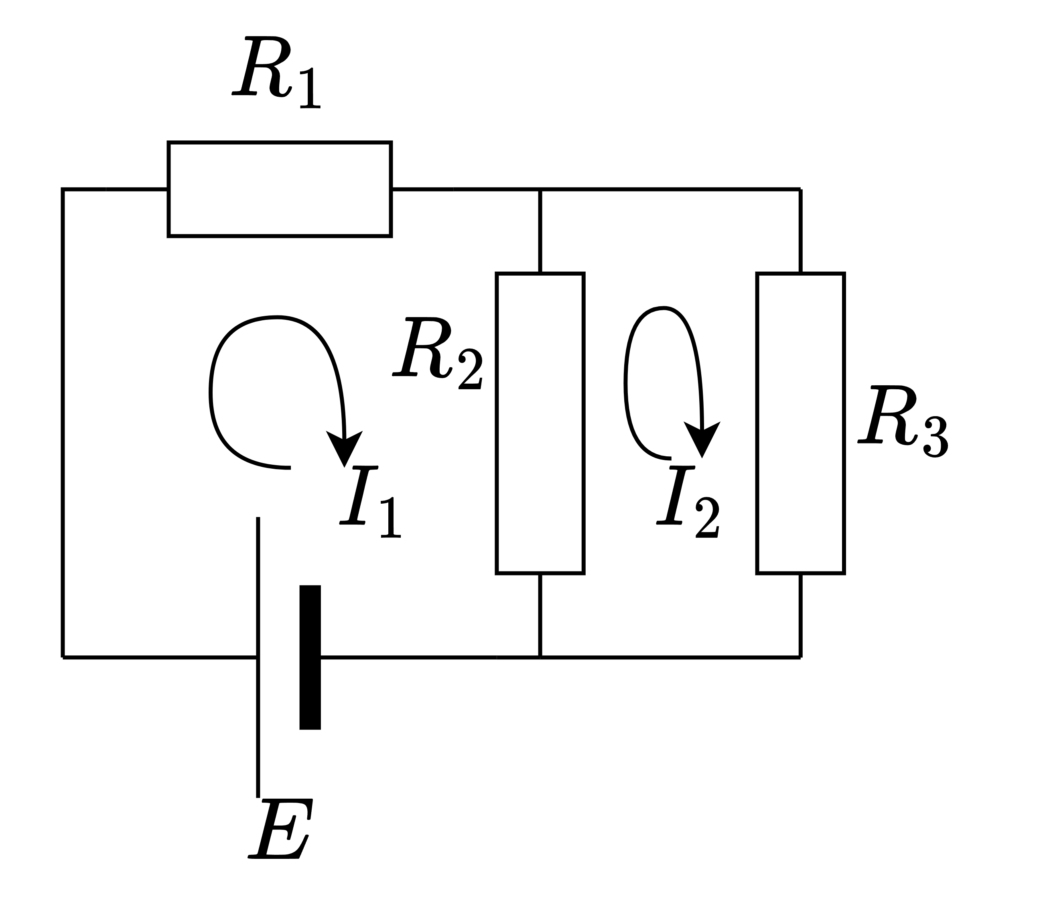
report/img/loop.drawio.png
