kzsh4124/class-info-media-experiment-B/report/img/loop_eqv.drawio.png

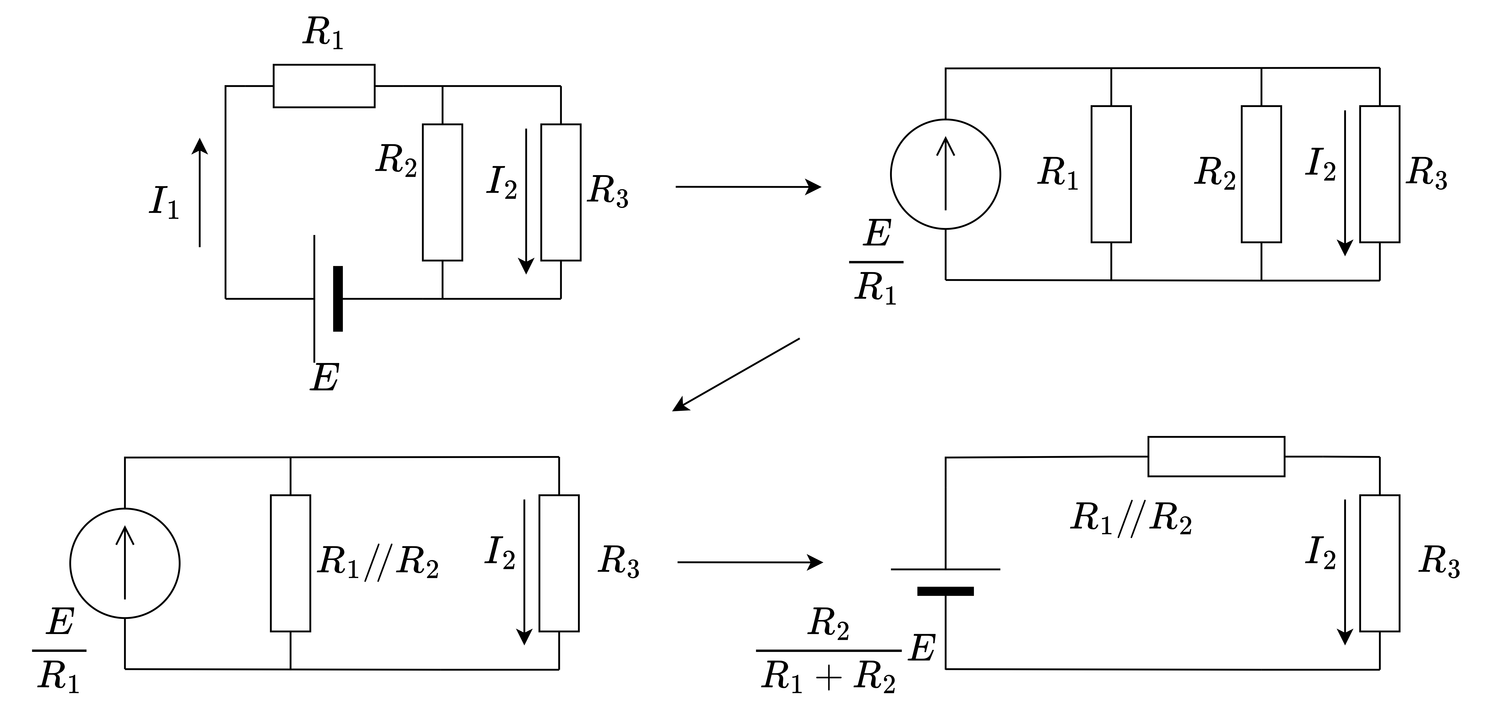
report/img/loop_eqv.drawio.png
