kzsh4124/class-info-media-experiment-B/report/img/loop_re.drawio.png

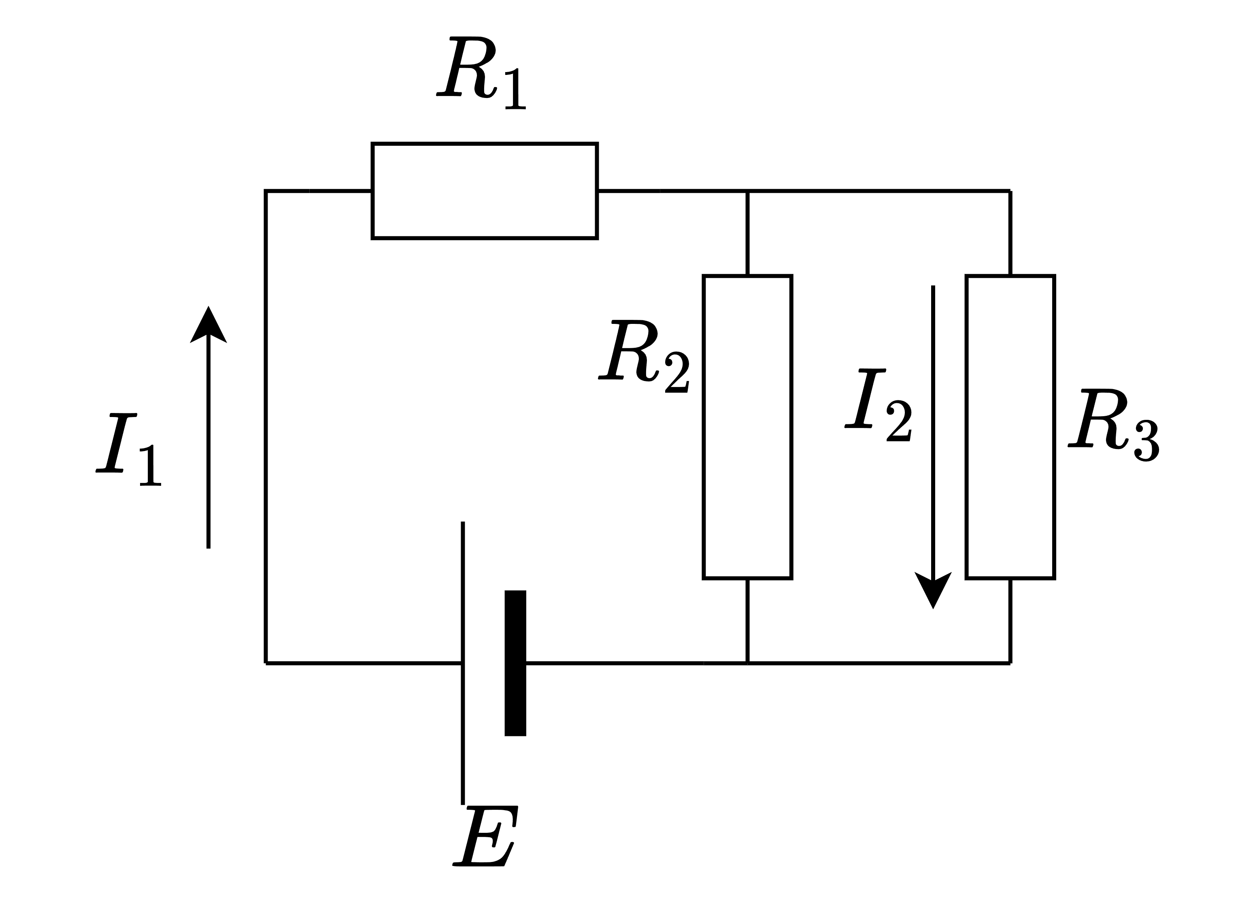
report/img/loop_re.drawio.png
