kzsh4124/class-info-media-experiment-B/report/img/ohm2.drawio.png

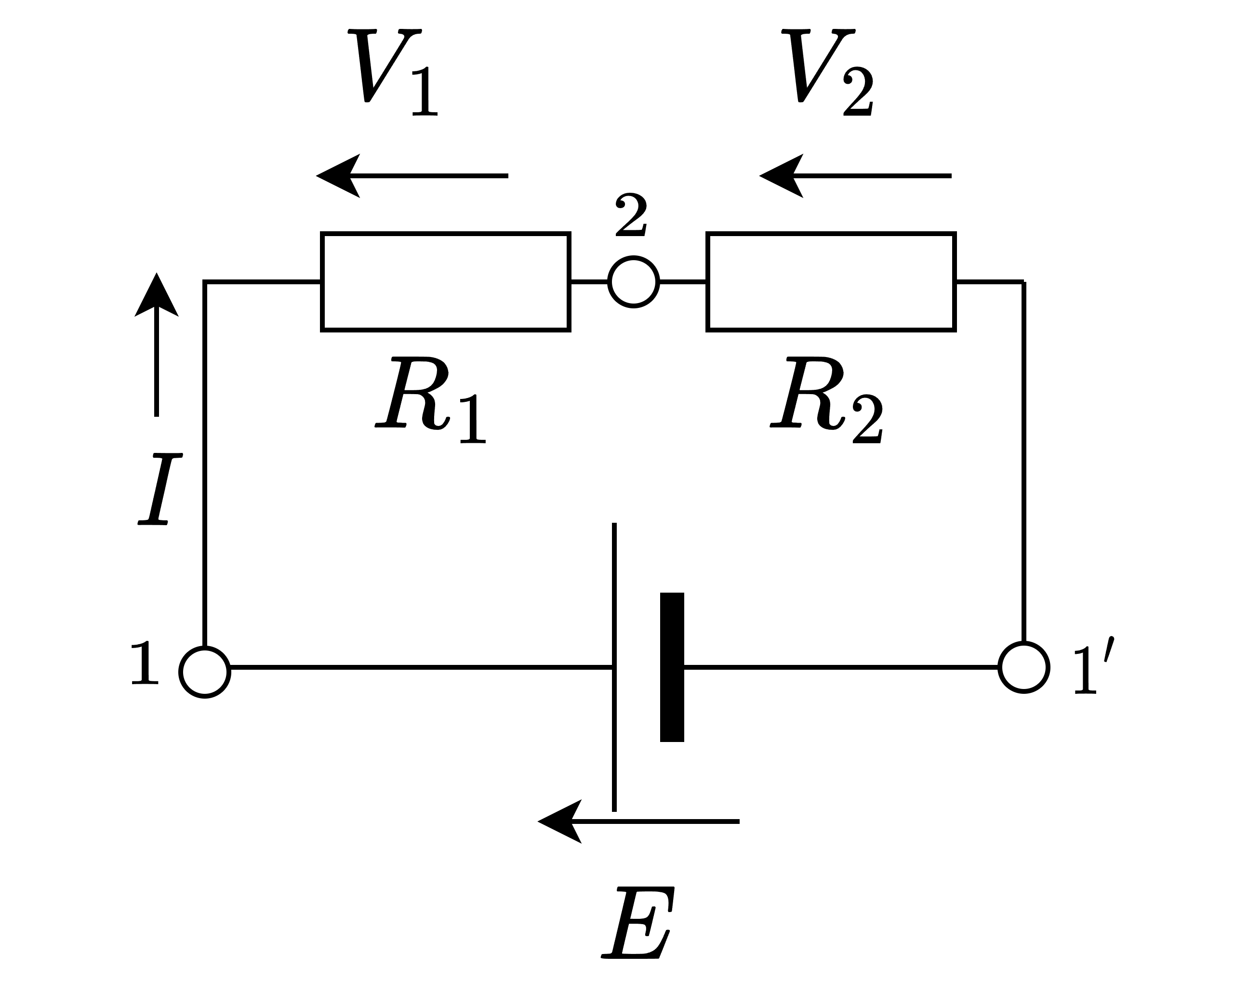
report/img/ohm2.drawio.png
