kzsh4124/class-info-media-experiment-B/report/img/ohm.drawio.png

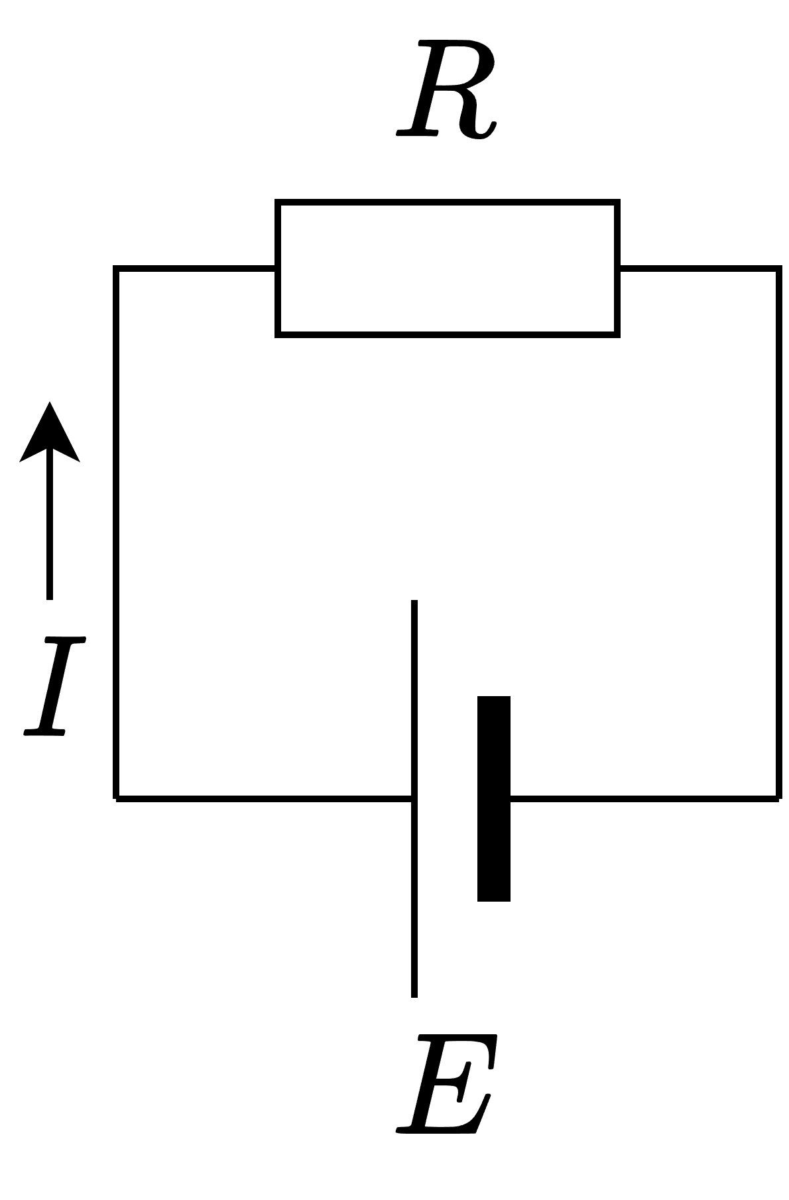
report/img/ohm.drawio.png
