kzsh4124/class-info-media-experiment-B/report/img/para.drawio.png

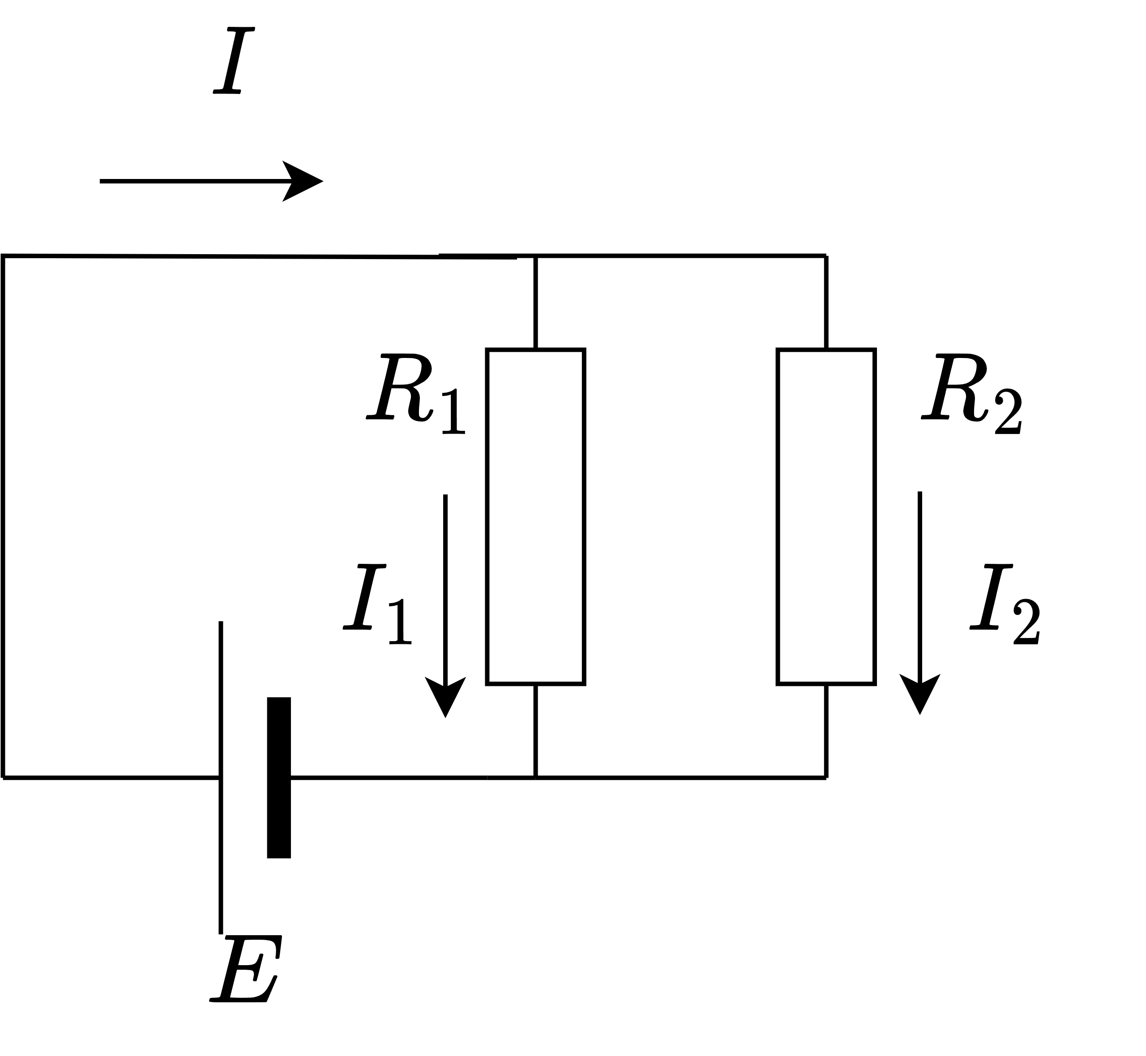
report/img/para.drawio.png
