kzsh4124/class-info-media-experiment-B/report/img/real_battery2.drawio.png

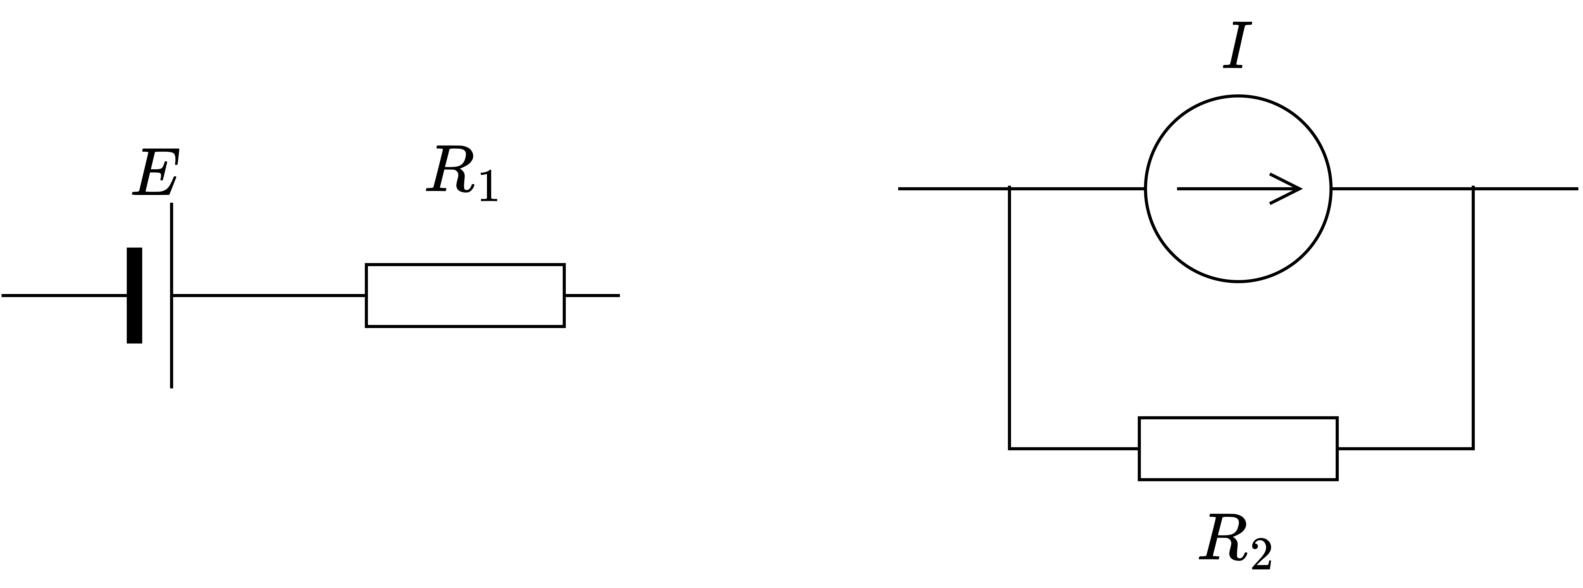
report/img/real_battery2.drawio.png
