kzsh4124/class-info-media-experiment-B/report/img/sensor_theta.drawio.png

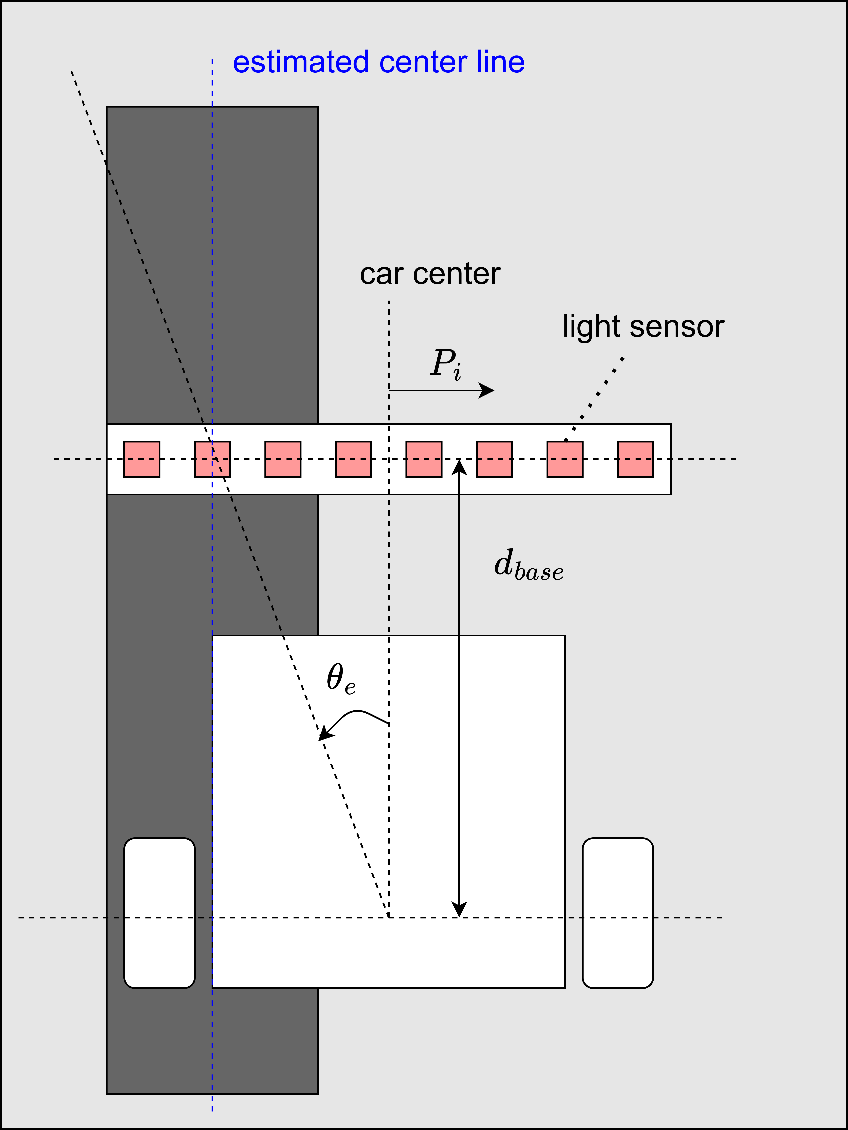
report/img/sensor_theta.drawio.png
