kzsh4124/class-info-media-experiment-B/report/img/short_open.drawio.png

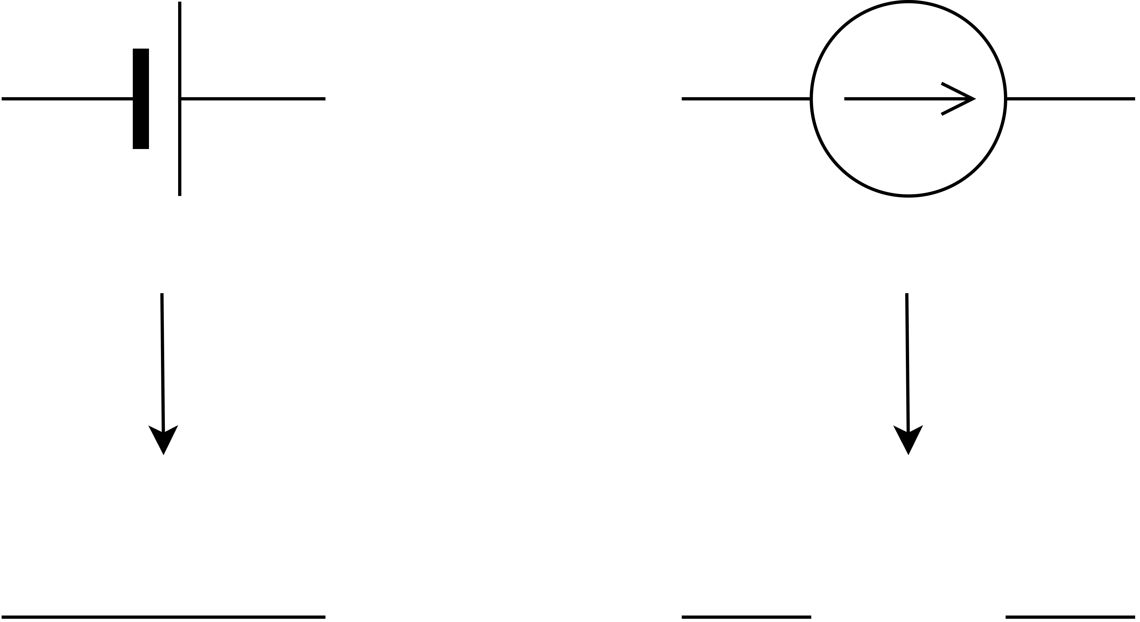
report/img/short_open.drawio.png
