kzsh4124/class-info-media-experiment-B/report/img/Thevenin.drawio.png

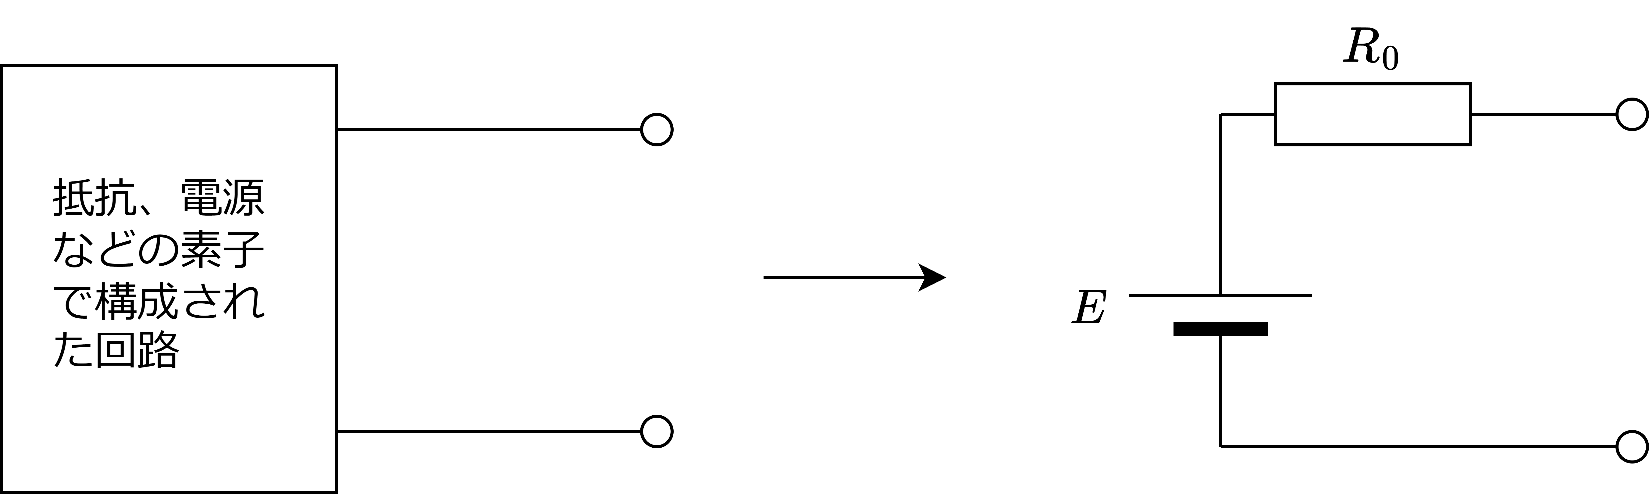
report/img/Thevenin.drawio.png
